JeremyL71/GMP-Projet-fusex/CAO/Bluemoon 1bis (last)2/bride de maintien.SLDPRT

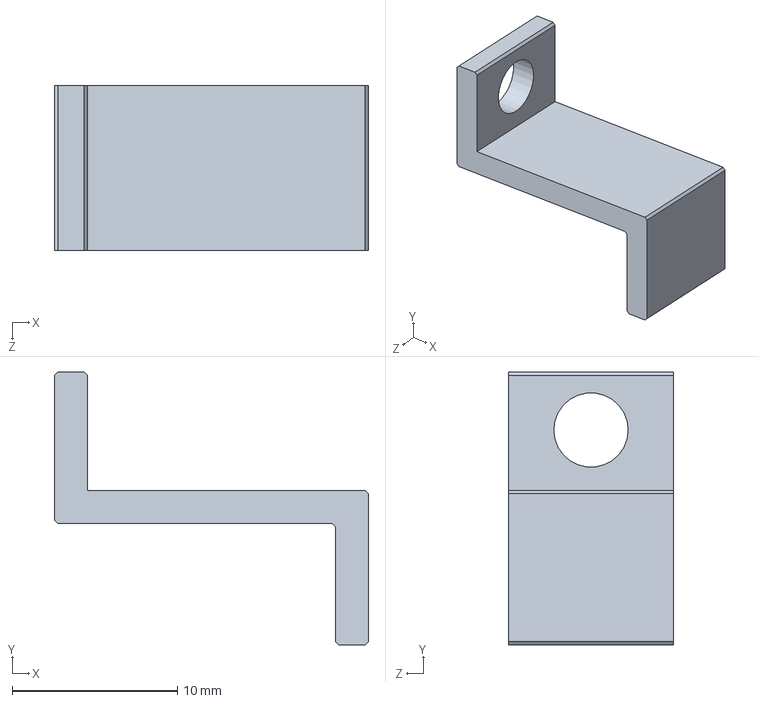
[picture p10: CAD file, 2020-04-03]
CAO/Bluemoon 1bis (last)2/bride de maintien.SLDPRT
19.0 x 16.5 x 10.0 mm
