JeremyL71/GMP-Projet-fusex/CAO/Bluemoon 1bis (last)2/SA aileronss.SLDASM

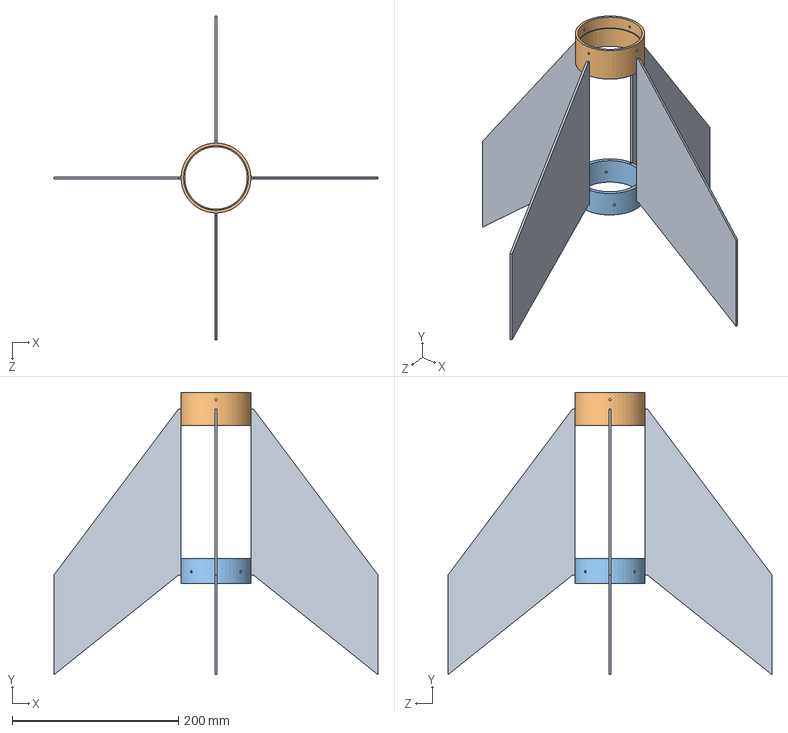
[picture p11: CAD file, 2020-04-03]
CAO/Bluemoon 1bis (last)2/SA aileronss.SLDASM
390.0 x 340.0 x 390.0 mm
Aileron x 4
Bague Ailerons
Bague Ailerons 2
