JeremyL71/GMP-Projet-fusex/CAO/support/Support.SLDASM

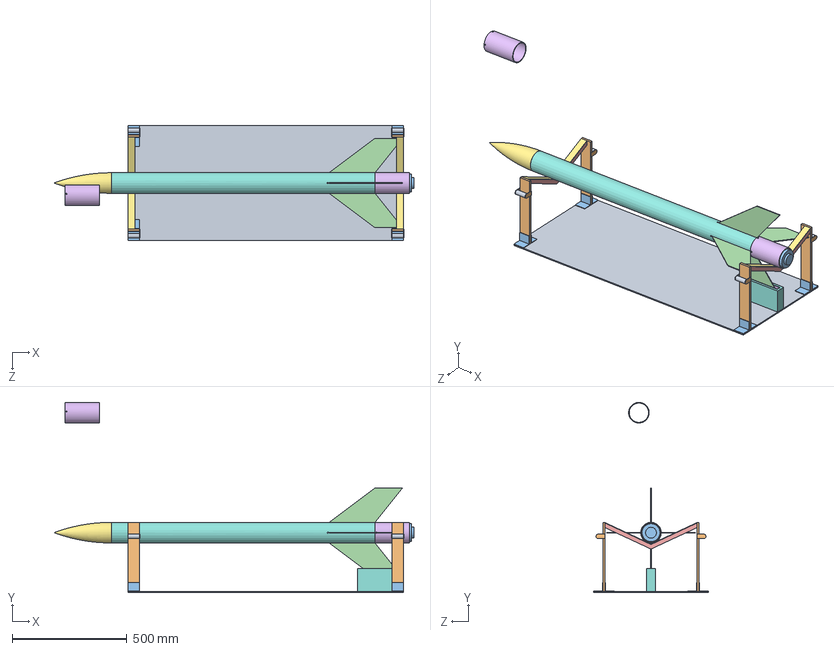
[picture p12: CAD file, 2020-04-03]
CAO/support/Support.SLDASM
1570.0 x 829.5 x 500.0 mm
Plaque
Barre verticel x 4
maintient x 8
Aileron x 4
Bague Ailerons x 2
ogive 1bis
Tube supérieur
Tube Bas
Cloison x 2
tube capteurs 1bis
Moteur 1bis
Bague supérieur moteur
Pièce1 x 2
revetPièce2
dessusPièce1 x 2
Pièce2 x 2
Pièce3 x 4
Pièce4 x 8
