JeremyL71/GMP-Projet-fusex/CAO/Bluemoon 1bis (last)2/Sol 1 Porte Capteurs.SLDASM

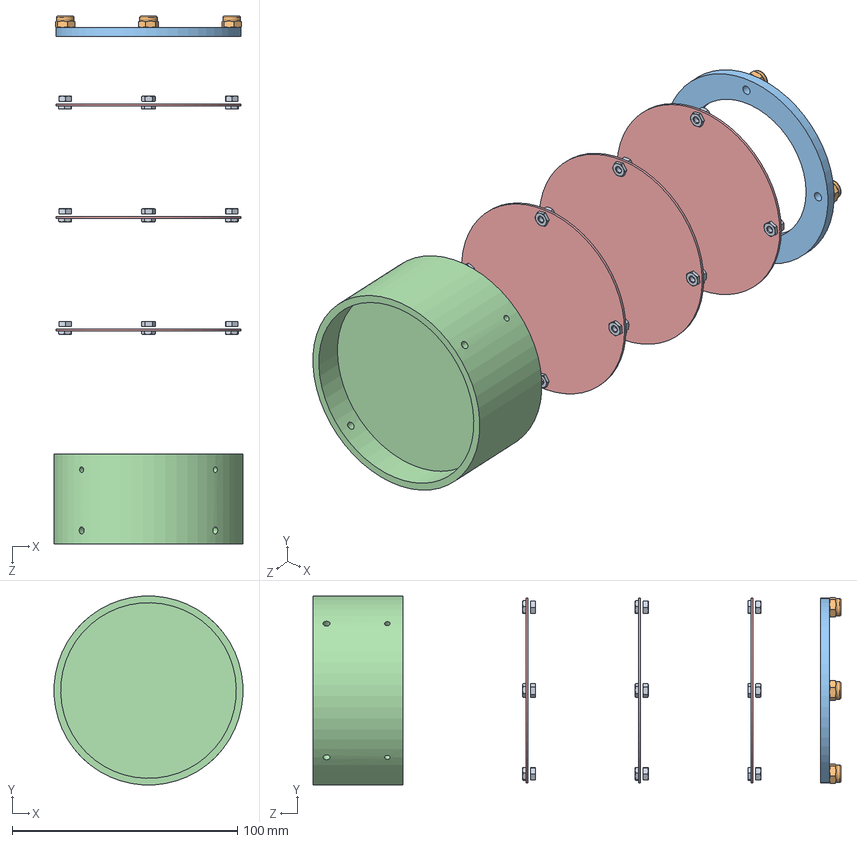
[picture p13: CAD file, 2020-04-03]
CAO/Bluemoon 1bis (last)2/Sol 1 Porte Capteurs.SLDASM
83.8 x 83.8 x 234.5 mm
Cloison
+®crou autofrein+® x 4
Cloison 2
Porte capteur x 3
+®crou m3 x 24
