JeremyL71/GMP-Projet-fusex/CAO/support/SA AILERONS.SLDASM

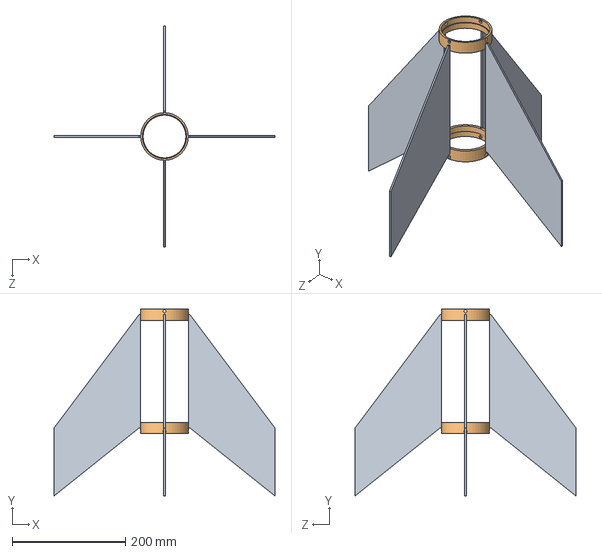
[picture p14: CAD file, 2020-04-03]
CAO/support/SA AILERONS.SLDASM
390.0 x 330.0 x 390.0 mm
Aileron x 4
Bague Ailerons x 2
