JeremyL71/GMP-Projet-fusex/CAO/support/1. SA CORP.SLDASM

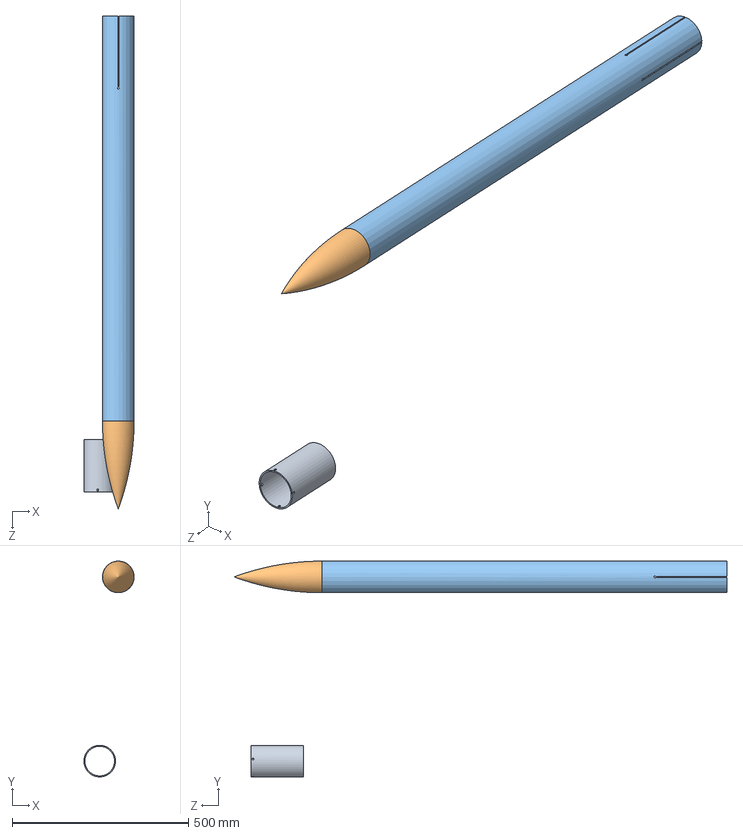
[picture p15: CAD file, 2020-04-03]
CAO/support/1. SA CORP.SLDASM
142.8 x 613.1 x 1400.0 mm
Tube Bas
ogive 1bis
Tube supérieur
