JeremyL71/GMP-Projet-fusex/CAO/Bluemoon 1bis (last)2/FUSEE 1BIS 2.SLDASM

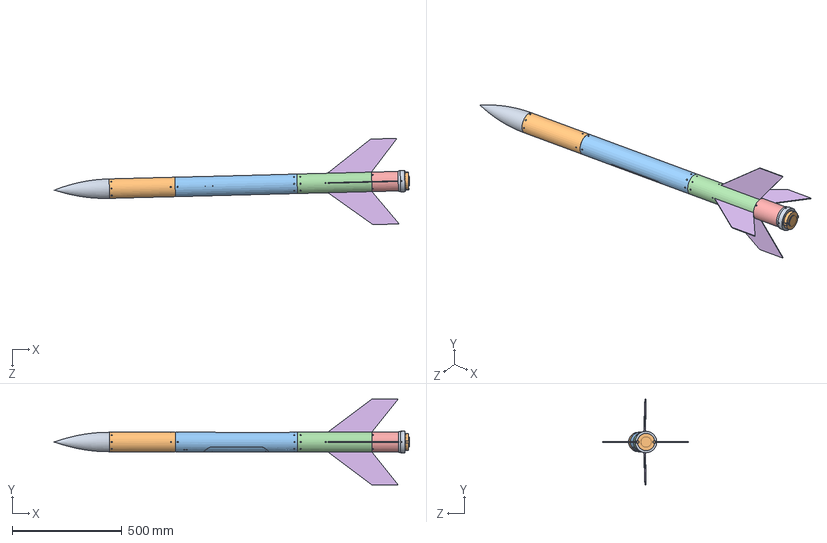
[picture p16: CAD file, 2020-04-03]
CAO/Bluemoon 1bis (last)2/FUSEE 1BIS 2.SLDASM
1617.3 x 390.0 x 393.0 mm
ogive 2
tube haut
Tube 2
Tube 3a
Tube 4
Aileron x 4
Bague Ailerons
Bague Ailerons 2
Cloison pleine
Propulseur
Cloison
tige filet+® x 4
+®crou autofrein+® x 4
Cloison 2
Porte capteur x 3
+®crou m3 x 24
Bague maintient bas
bride de maintien x 2
Trappe
Servo 360
Disque servo
Guidage goupille
Bride servo x 2
Rivets d3x10x120 x 50
Maintien goupille
Guidage ressort
