JeremyL71/GMP-Projet-fusex/CAO/support/fusée 1bis 2.SLDASM

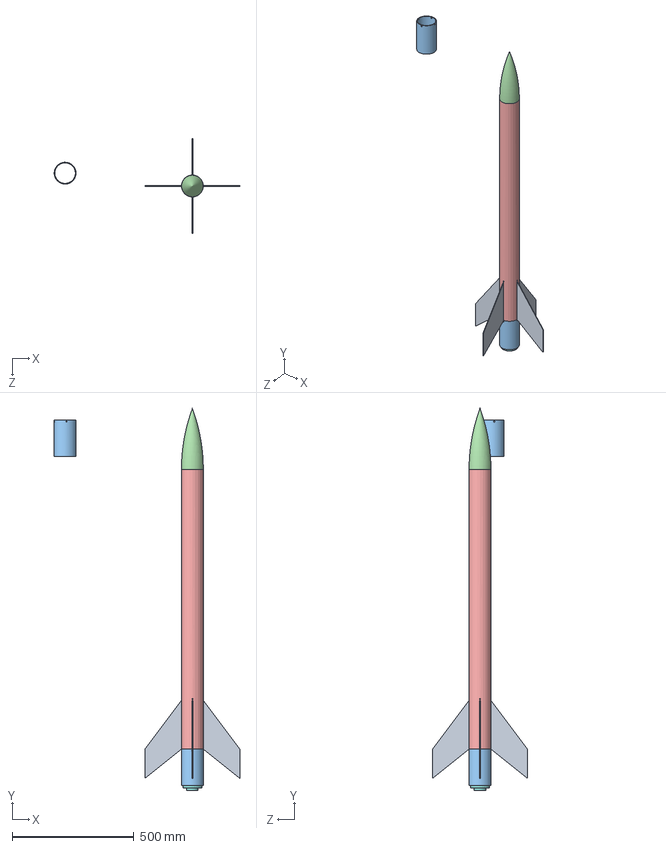
[picture p17: CAD file, 2020-04-03]
CAO/support/fusée 1bis 2.SLDASM
763.1 x 1570.0 x 390.0 mm
Aileron x 4
Bague Ailerons x 2
ogive 1bis
Tube supérieur
Tube Bas
Cloison x 2
tube capteurs 1bis
Moteur 1bis
Bague supérieur moteur
