JeremyL71/GMP-Projet-fusex/CAO/support/maintient.SLDPRT

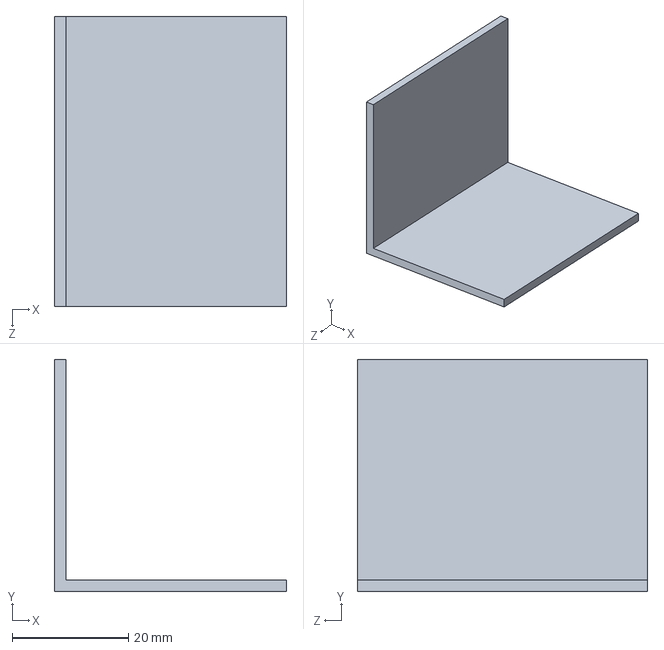
[picture p18: CAD file, 2020-04-03]
CAO/support/maintient.SLDPRT
40.0 x 40.0 x 50.0 mm
