JeremyL71/GMP-Projet-fusex/CAO/Bluemoon 1bis (last)2/Maintien goupille.SLDPRT

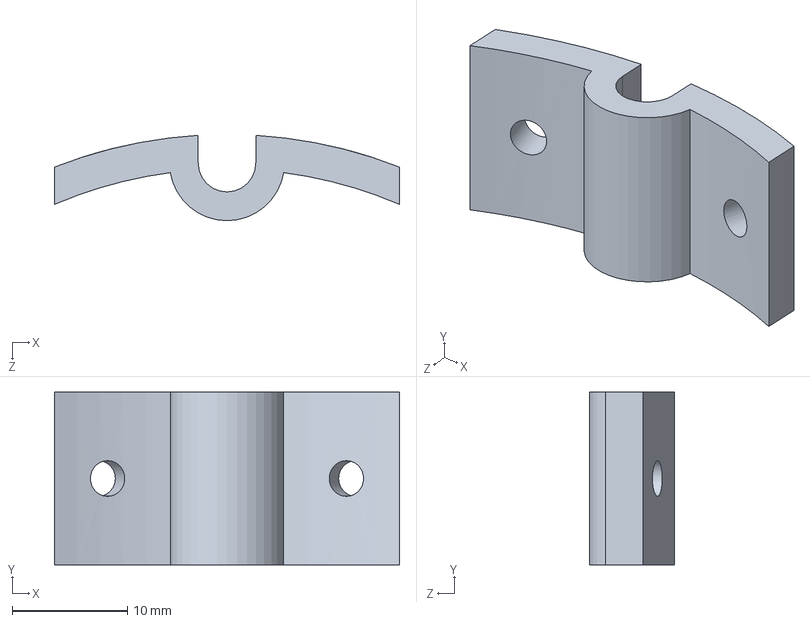
[picture p19: CAD file, 2020-04-03]
CAO/Bluemoon 1bis (last)2/Maintien goupille.SLDPRT
30.0 x 15.0 x 7.42 mm
