JeremyL71/GMP-Projet-fusex/CAO/support/poigné.SLDASM

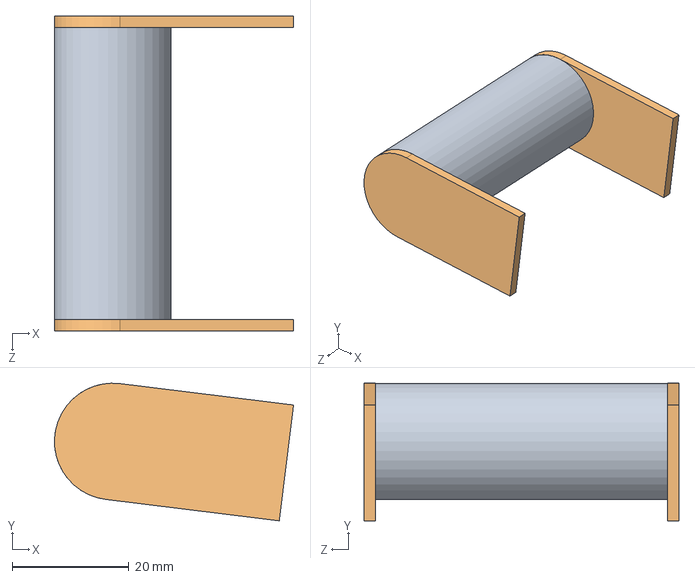
[picture p20: CAD file, 2020-04-03]
CAO/support/poigné.SLDASM
41.0 x 23.6 x 54.0 mm
Pièce3
Pièce4 x 2
