JeremyL71/GMP-Projet-fusex/CAO/Bluemoon 1bis (last)2/Bague maintient bas.SLDPRT

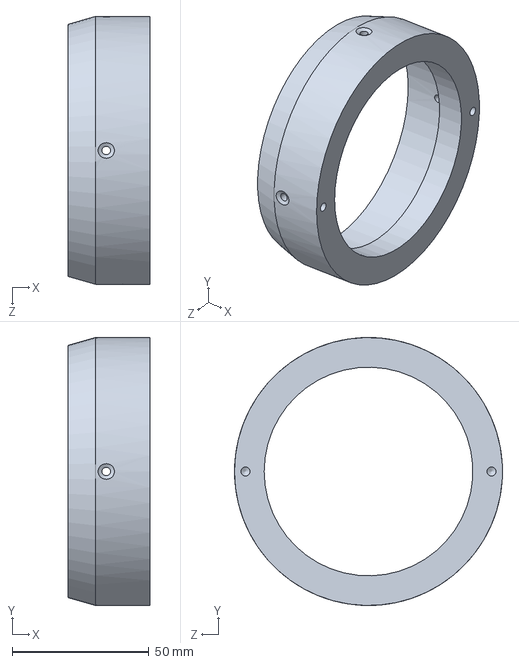
[picture p21: CAD file, 2020-04-03]
CAO/Bluemoon 1bis (last)2/Bague maintient bas.SLDPRT
30.0 x 98.0 x 98.0 mm
