JeremyL71/GMP-Projet-fusex/CAO/Bluemoon 1bis (last)2/Servo 360-¦.SLDASM

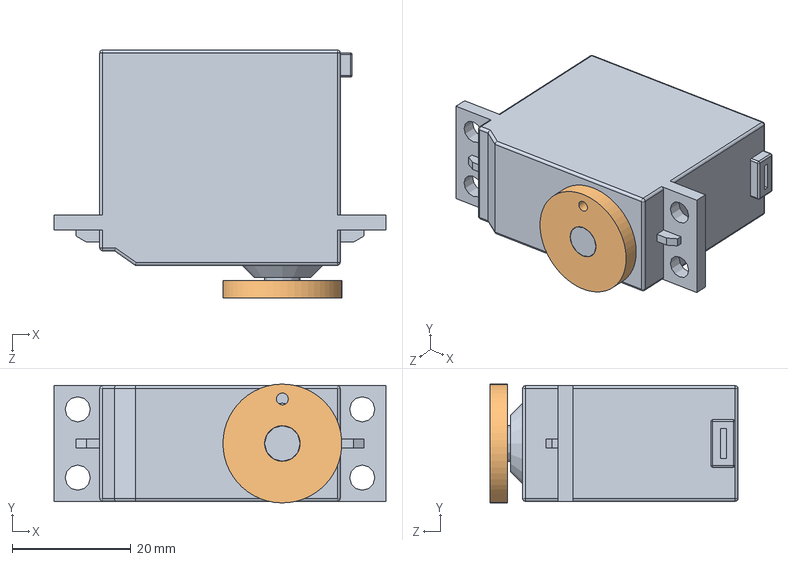
[picture p22: CAD file, 2020-04-03]
CAO/Bluemoon 1bis (last)2/Servo 360-¦.SLDASM
55.9 x 20.0 x 41.8 mm
Servo 360
Disque servo
