JeremyL71/GMP-Projet-fusex/CAO/Bluemoon 1bis (last)2/Disque servo.SLDPRT

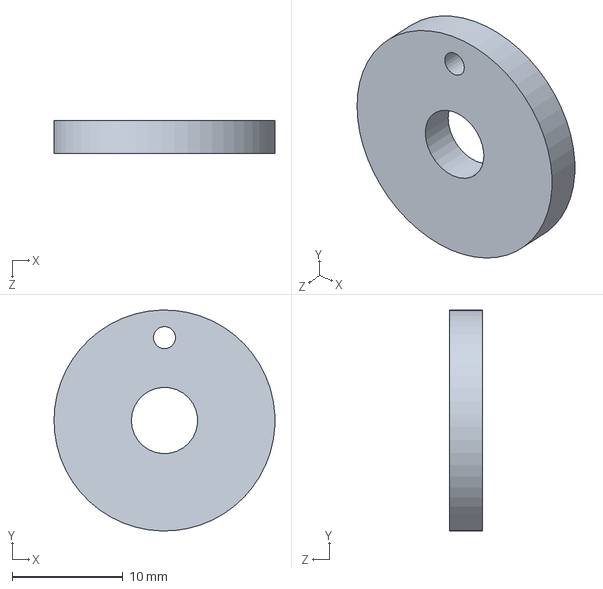
[picture p23: CAD file, 2020-04-03]
CAO/Bluemoon 1bis (last)2/Disque servo.SLDPRT
20.0 x 20.0 x 3.00 mm
