JeremyL71/GMP-Projet-fusex/CAO/Ogive/ogive 2 .STEP

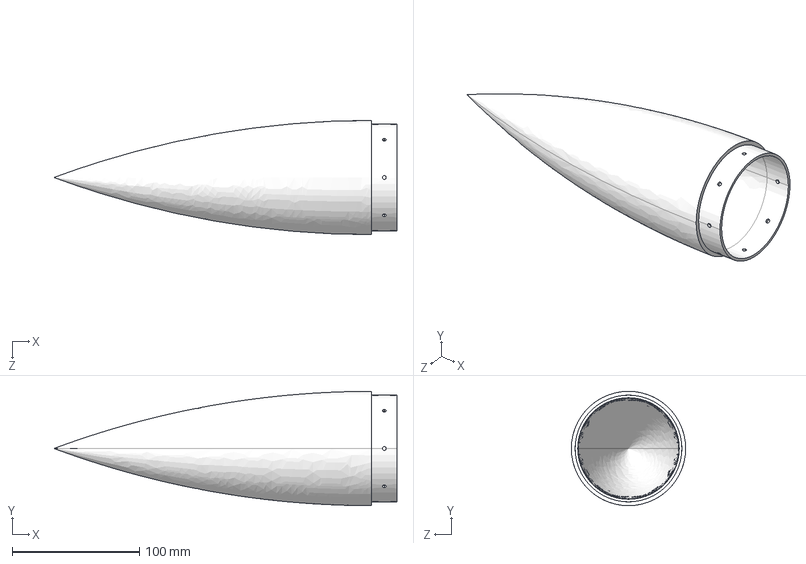
[picture p24: CAD file, 2020-04-03]
CAO/Ogive/ogive 2 .STEP
270.0 x 90.0 x 90.0 mm
