JeremyL71/GMP-Projet-fusex/CAO/support/Pièce1.SLDPRT

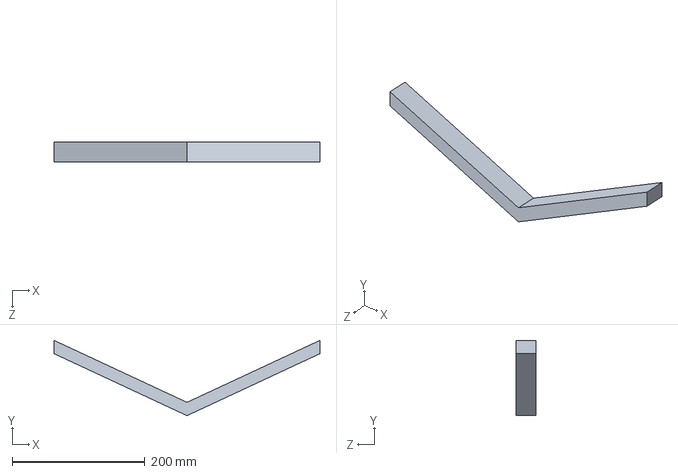
[picture p25: CAD file, 2020-04-03]
CAO/support/Pièce1.SLDPRT
400.0 x 113.3 x 30.0 mm
