JeremyL71/GMP-Projet-fusex/CAO/Bluemoon 1bis (last)2/rondelle +®ventail.SLDPRT

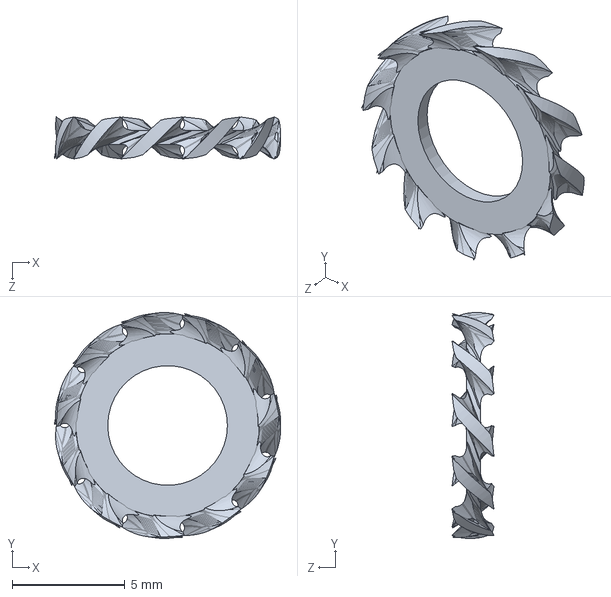
[picture p26: CAD file, 2020-04-03]
CAO/Bluemoon 1bis (last)2/rondelle +®ventail.SLDPRT
10.0 x 10.0 x 1.86 mm
