JeremyL71/GMP-Projet-fusex/CAO/support/Pièce5.SLDPRT

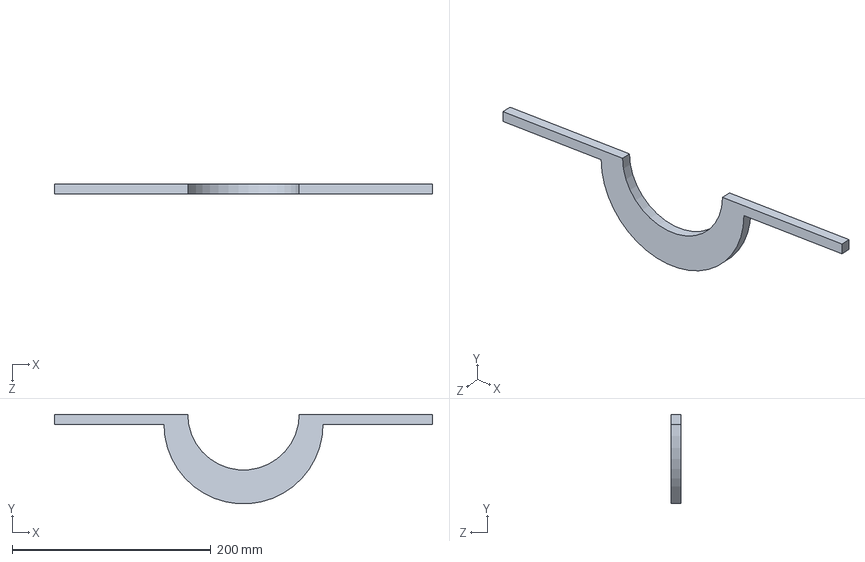
[picture p27: CAD file, 2020-04-03]
CAO/support/Pièce5.SLDPRT
380.0 x 89.8 x 10.0 mm
