JeremyL71/GMP-Projet-fusex/CAO/Bluemoon 1bis (last)2/Propulseur.SLDPRT

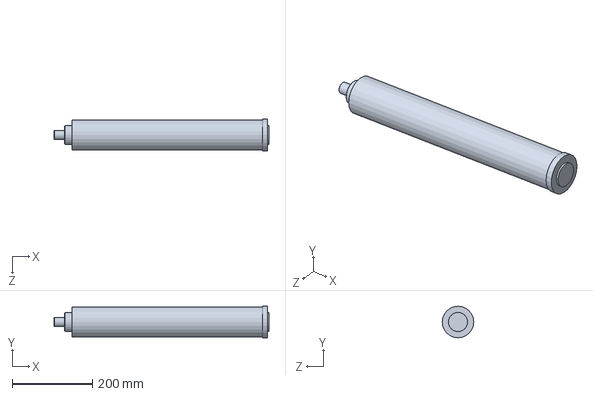
[picture p28: CAD file, 2020-04-03]
CAO/Bluemoon 1bis (last)2/Propulseur.SLDPRT
536.0 x 78.7 x 78.7 mm
