JeremyL71/GMP-Projet-fusex/CAO/Ogive/ogive 3 moule.SLDPRT

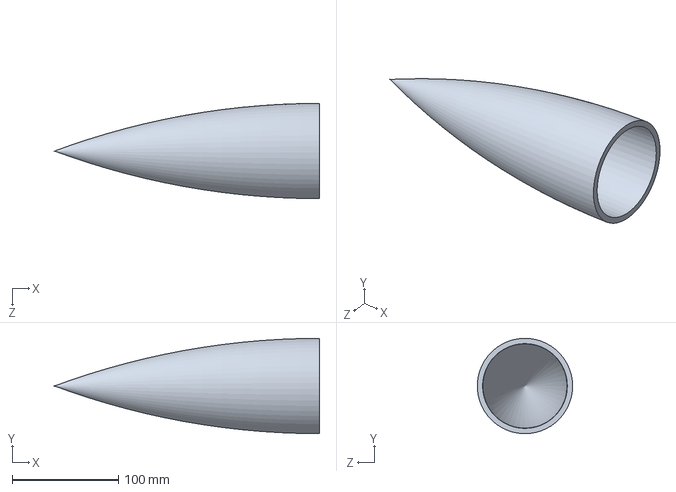
[picture p29: CAD file, 2020-04-03]
CAO/Ogive/ogive 3 moule.SLDPRT
250.0 x 90.0 x 89.9 mm
