JeremyL71/GMP-Projet-fusex/CAO/support/Tube supérieur.SLDPRT

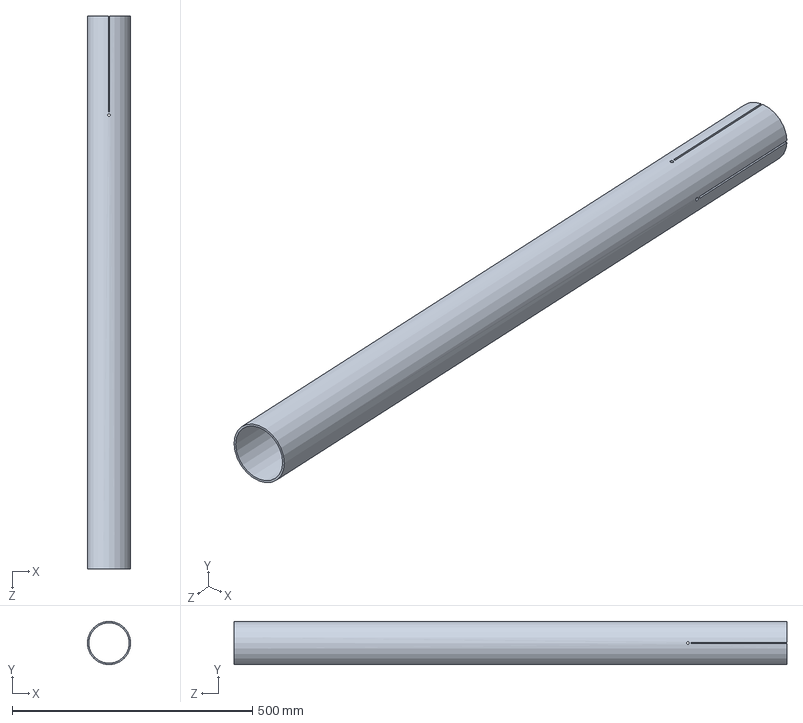
[picture p30: CAD file, 2020-04-03]
CAO/support/Tube supérieur.SLDPRT
90.0 x 90.0 x 1150.0 mm
