JeremyL71/GMP-Projet-fusex/CAO/Bluemoon 1bis (last)2/Aileron.SLDPRT

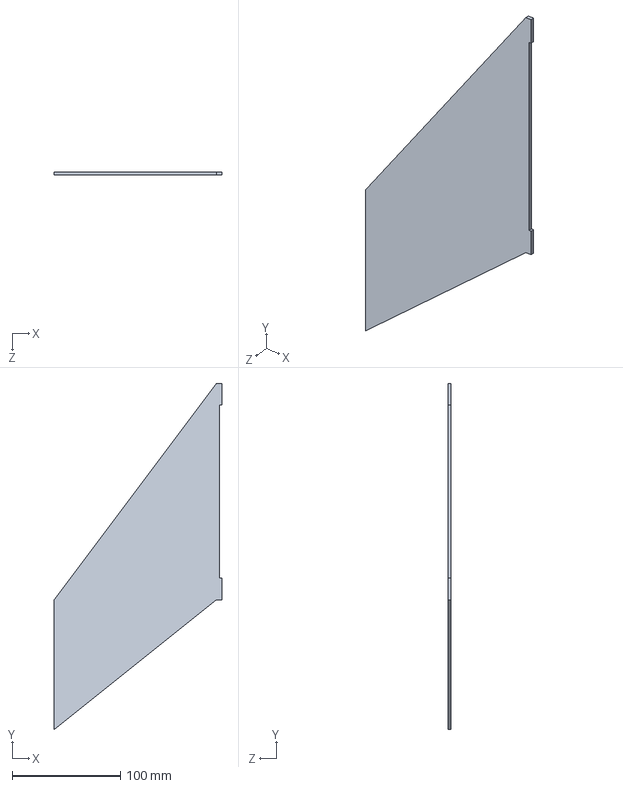
[picture p31: CAD file, 2020-04-03]
CAO/Bluemoon 1bis (last)2/Aileron.SLDPRT
155.0 x 320.0 x 3.00 mm
