JeremyL71/GMP-Projet-fusex/CAO/support/ogive 1bis.SLDPRT

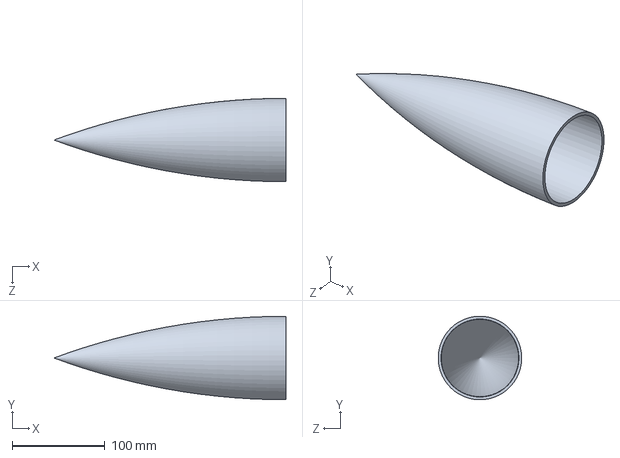
[picture p32: CAD file, 2020-04-03]
CAO/support/ogive 1bis.SLDPRT
250.0 x 90.0 x 89.9 mm
