JeremyL71/GMP-Projet-fusex/CAO/support/Bague supérieur moteur.SLDPRT

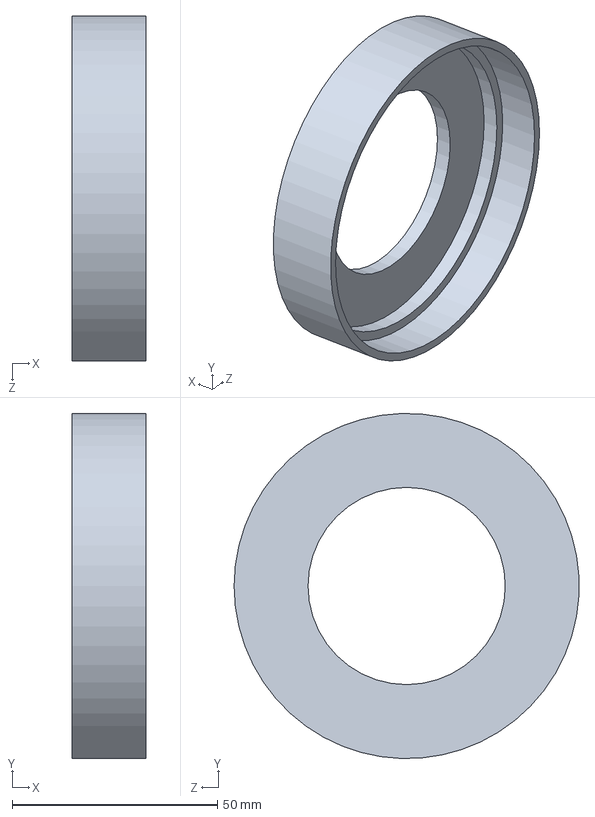
[picture p33: CAD file, 2020-04-03]
CAO/support/Bague supérieur moteur.SLDPRT
18.0 x 84.0 x 83.9 mm
