JeremyL71/GMP-Projet-fusex/CAO/Bluemoon 1bis (last)2/Cloison pleine.SLDPRT

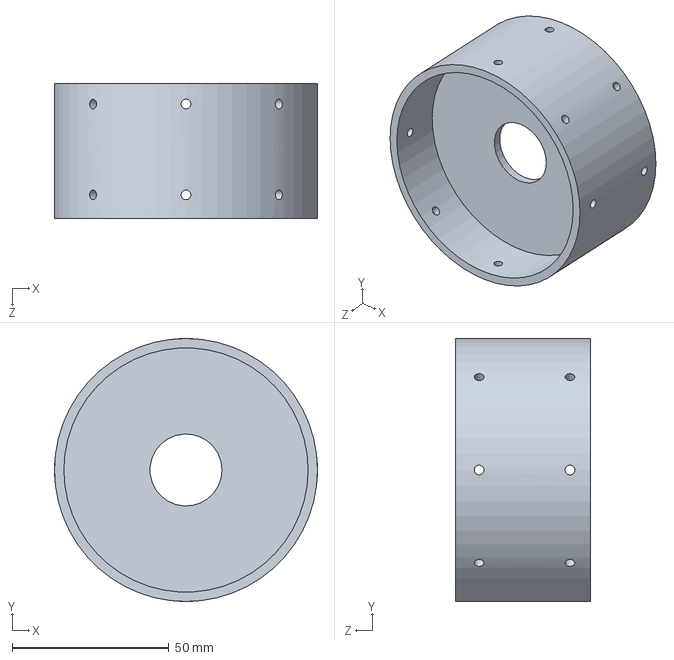
[picture p34: CAD file, 2020-04-03]
CAO/Bluemoon 1bis (last)2/Cloison pleine.SLDPRT
84.0 x 84.0 x 43.0 mm
