JeremyL71/GMP-Projet-fusex/CAO/support/Pièce2.SLDPRT

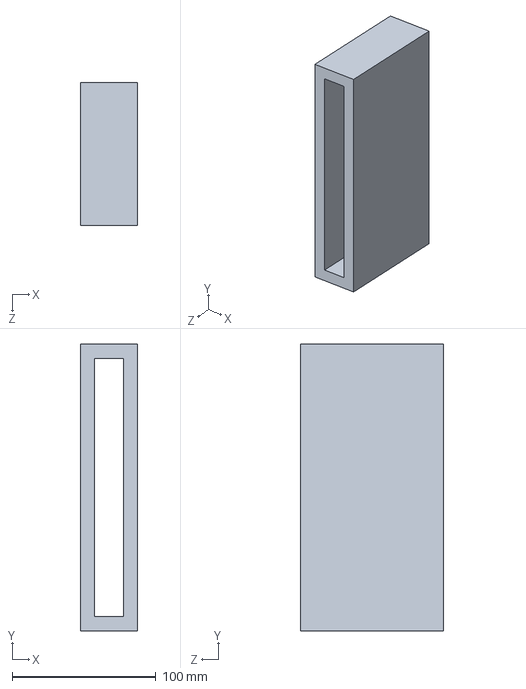
[picture p35: CAD file, 2020-04-03]
CAO/support/Pièce2.SLDPRT
40.0 x 200.0 x 100.0 mm
