JeremyL71/GMP-Projet-fusex/CAO/support/tube capteurs 1bis.SLDPRT

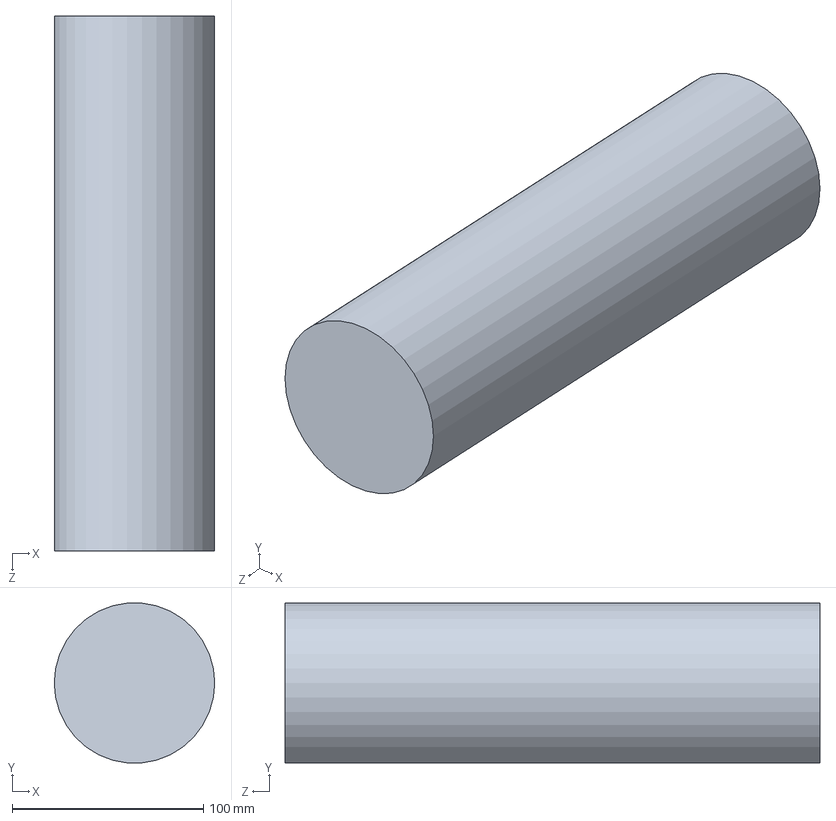
[picture p36: CAD file, 2020-04-03]
CAO/support/tube capteurs 1bis.SLDPRT
84.0 x 83.6 x 280.0 mm
