JeremyL71/GMP-Projet-fusex/CAO/Bluemoon 1bis (last)2/Tube 2.SLDPRT

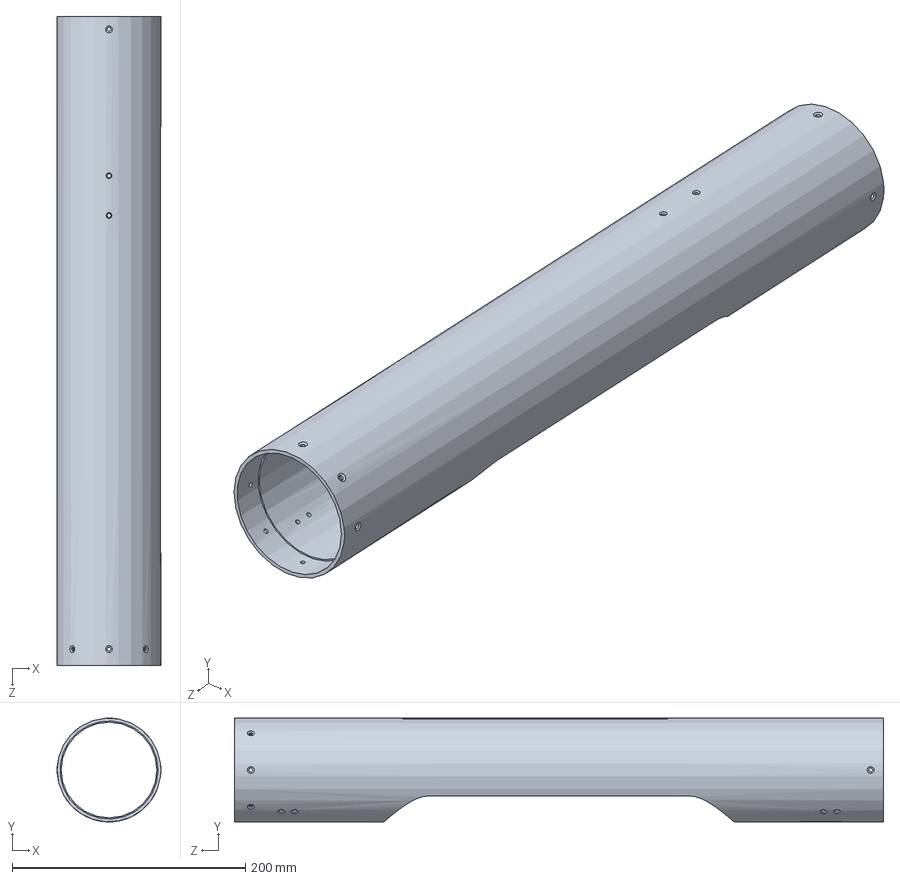
[picture p37: CAD file, 2020-04-03]
CAO/Bluemoon 1bis (last)2/Tube 2.SLDPRT
89.0 x 89.0 x 556.0 mm
