JeremyL71/GMP-Projet-fusex/CAO/support/Pièce3.SLDPRT

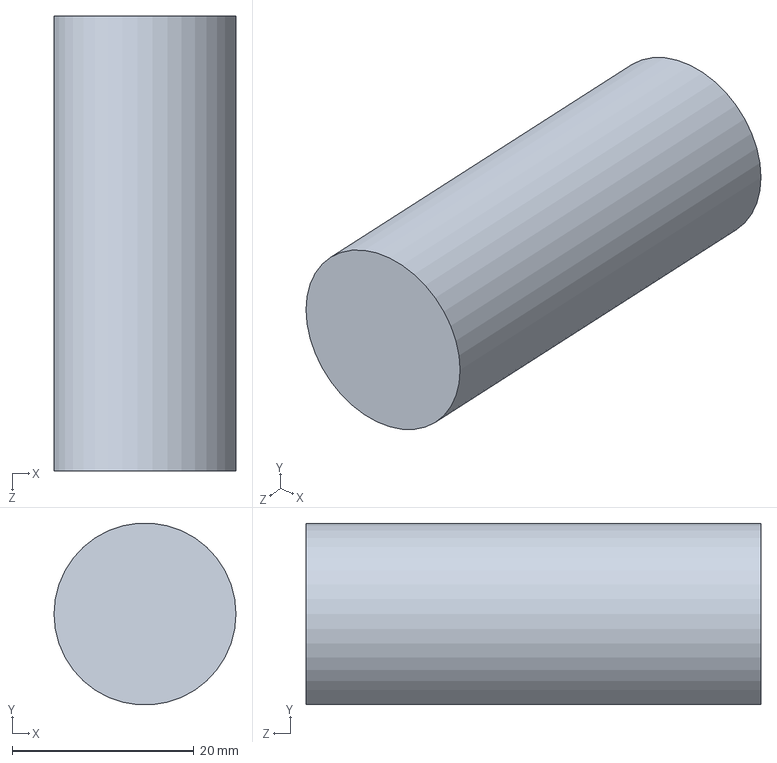
[picture p38: CAD file, 2020-04-03]
CAO/support/Pièce3.SLDPRT
20.0 x 19.9 x 50.0 mm
