JeremyL71/GMP-Projet-fusex/CAO/Bluemoon 1bis (last)2/Guidage goupille.SLDPRT

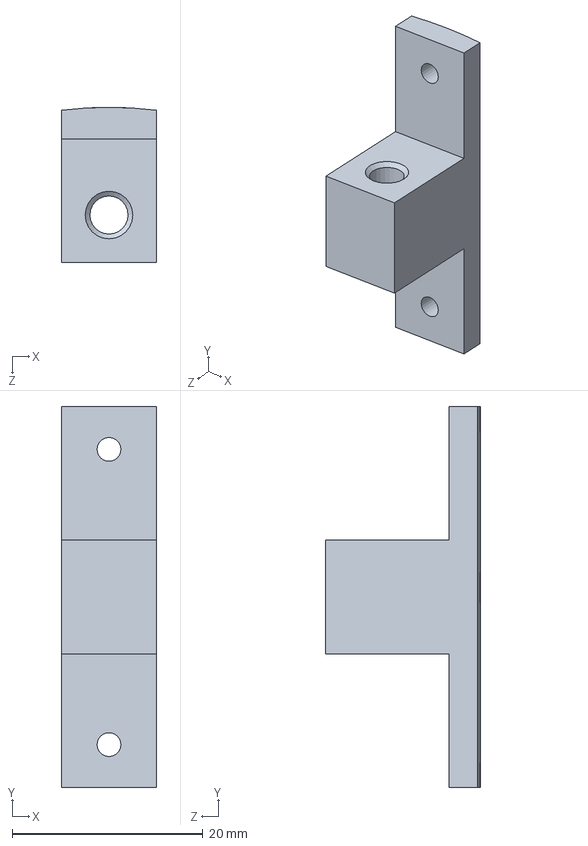
[picture p39: CAD file, 2020-04-03]
CAO/Bluemoon 1bis (last)2/Guidage goupille.SLDPRT
10.0 x 40.0 x 16.3 mm
