JeremyL71/GMP-Projet-fusex/CAO/support/dessusPièce1.SLDPRT

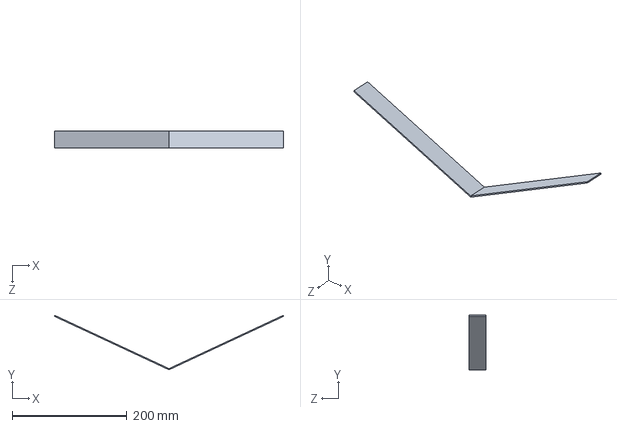
[picture p40: CAD file, 2020-04-03]
CAO/support/dessusPièce1.SLDPRT
400.0 x 95.3 x 30.0 mm
