JeremyL71/GMP-Projet-fusex/CAO/Bluemoon 1bis (last)2/Guidage ressort.SLDPRT

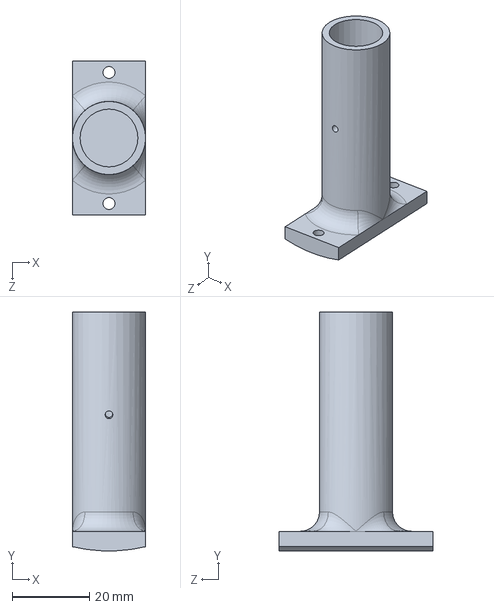
[picture p41: CAD file, 2020-04-03]
CAO/Bluemoon 1bis (last)2/Guidage ressort.SLDPRT
19.0 x 62.0 x 40.0 mm
