JeremyL71/GMP-Projet-fusex/CAO/support/Barre TRansverse.SLDPRT

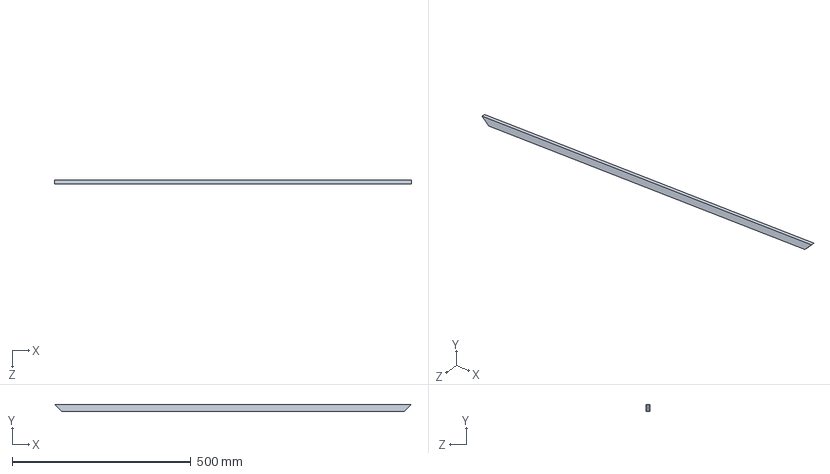
[picture p42: CAD file, 2020-04-03]
CAO/support/Barre TRansverse.SLDPRT
1000.0 x 20.0 x 10.0 mm
