JeremyL71/GMP-Projet-fusex/CAO/Bluemoon 1bis (last)2/Trappe.SLDPRT

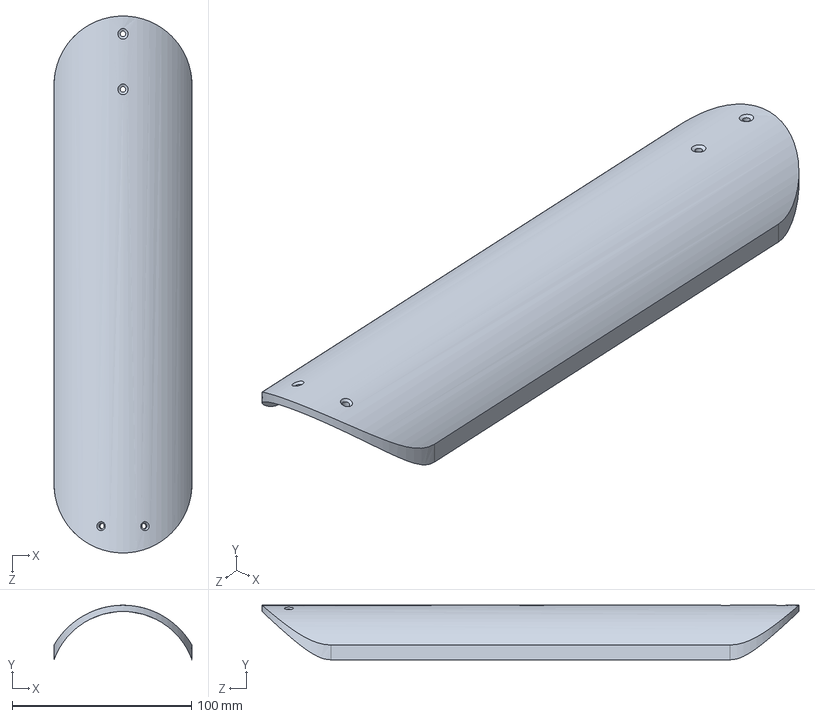
[picture p43: CAD file, 2020-04-03]
CAO/Bluemoon 1bis (last)2/Trappe.SLDPRT
77.1 x 30.5 x 300.0 mm
