JeremyL71/GMP-Projet-fusex/CAO/support/Bague Ailerons.SLDPRT

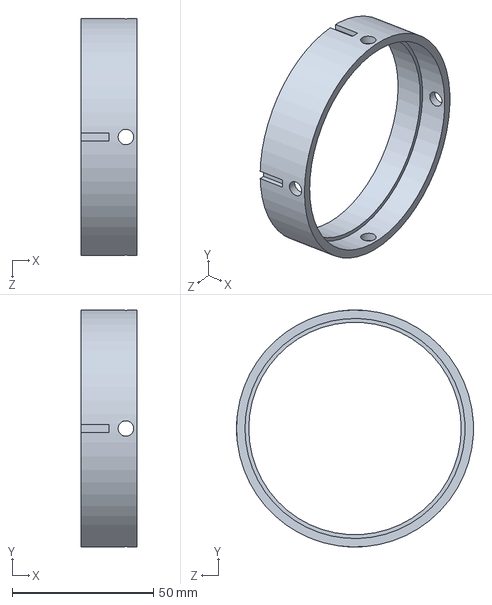
[picture p44: CAD file, 2020-04-03]
CAO/support/Bague Ailerons.SLDPRT
20.0 x 84.0 x 84.0 mm
