JeremyL71/GMP-Projet-fusex/CAO/Bluemoon 1bis (last)2/+®crou autofrein+®.SLDPRT

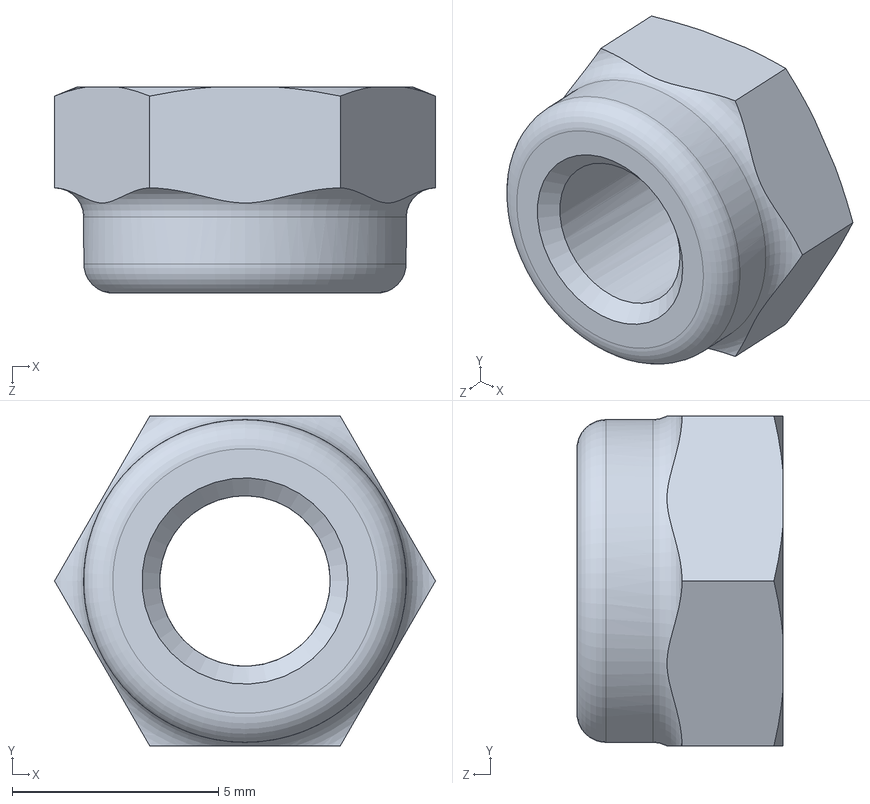
[picture p45: CAD file, 2020-04-03]
CAO/Bluemoon 1bis (last)2/+®crou autofrein+®.SLDPRT
9.24 x 8.00 x 5.00 mm
