JeremyL71/GMP-Projet-fusex/CAO/support/Bague inférieure moteur.SLDPRT

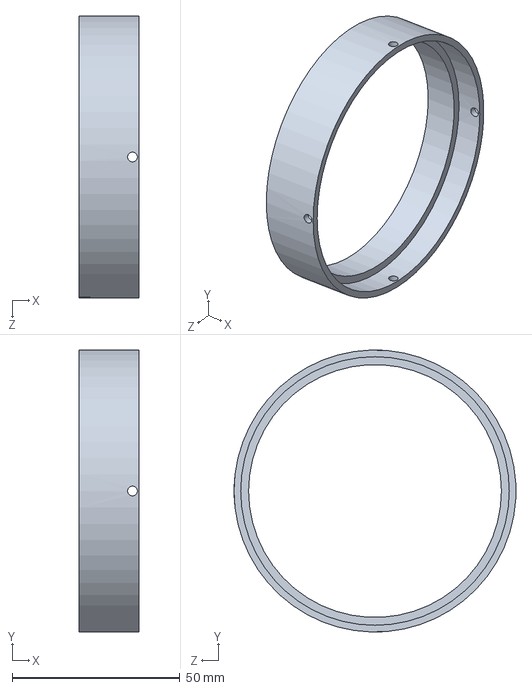
[picture p46: CAD file, 2020-04-03]
CAO/support/Bague inférieure moteur.SLDPRT
18.0 x 84.0 x 84.0 mm
