JeremyL71/GMP-Projet-fusex/CAO/Bluemoon 1bis (last)2/+®crou m3.SLDPRT

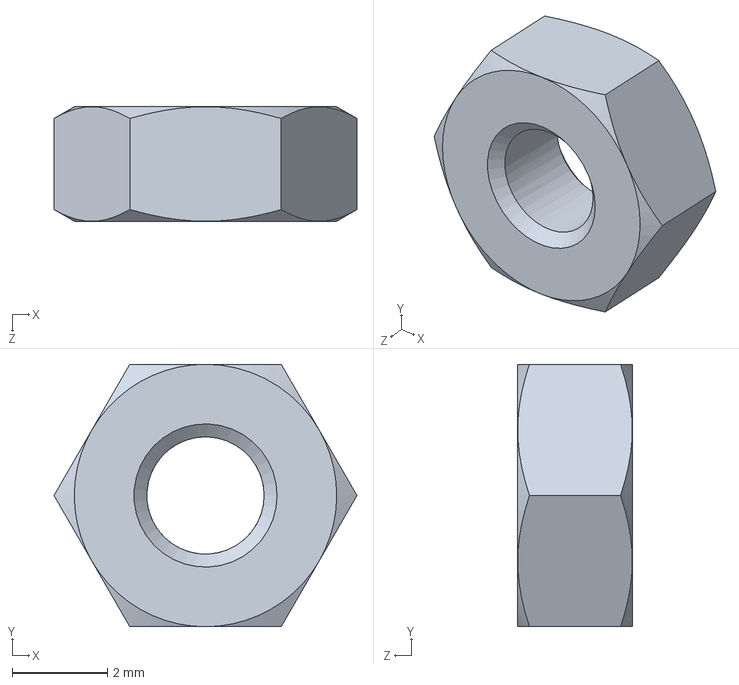
[picture p47: CAD file, 2020-04-03]
CAO/Bluemoon 1bis (last)2/+®crou m3.SLDPRT
6.35 x 5.50 x 2.40 mm
