JeremyL71/GMP-Projet-fusex/CAO/support/Barre verticel.SLDPRT

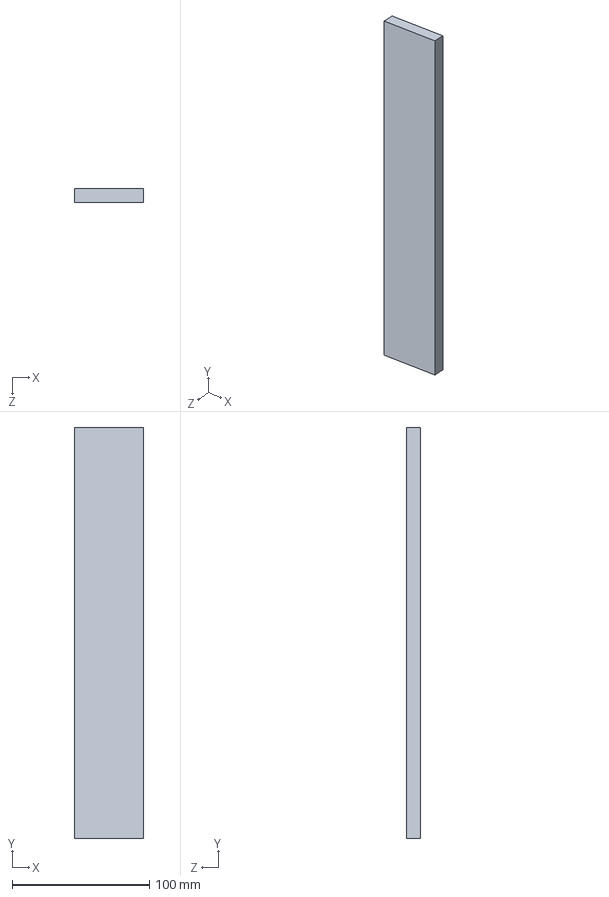
[picture p48: CAD file, 2020-04-03]
CAO/support/Barre verticel.SLDPRT
50.0 x 300.0 x 10.0 mm
