JeremyL71/GMP-Projet-fusex/CAO/Bluemoon 1bis (last)2/ogive 2 .SLDPRT

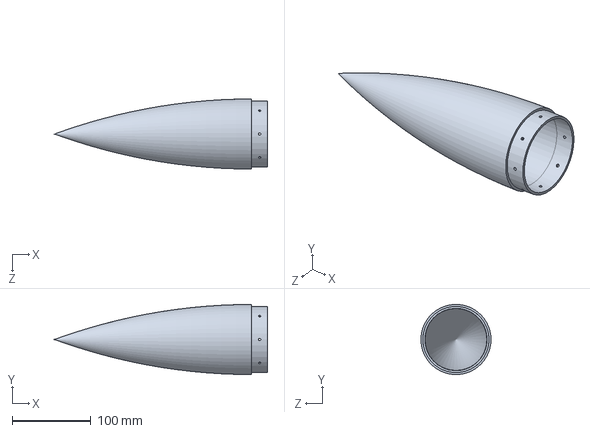
[picture p49: CAD file, 2020-04-03]
CAO/Bluemoon 1bis (last)2/ogive 2 .SLDPRT
270.0 x 89.0 x 88.9 mm
