JeremyL71/GMP-Projet-fusex/CAO/support/Tube Bas.SLDPRT

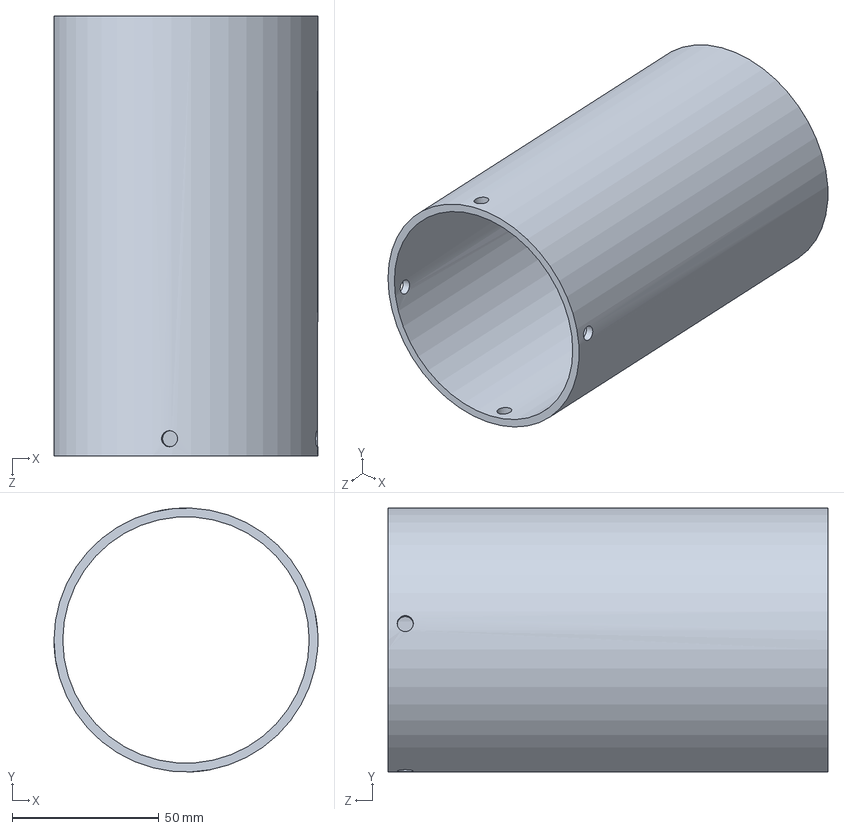
[picture p50: CAD file, 2020-04-03]
CAO/support/Tube Bas.SLDPRT
90.0 x 89.9 x 150.0 mm
