JeremyL71/GMP-Projet-fusex/CAO/Bluemoon 1bis (last)2/Bague Ailerons 2.SLDPRT

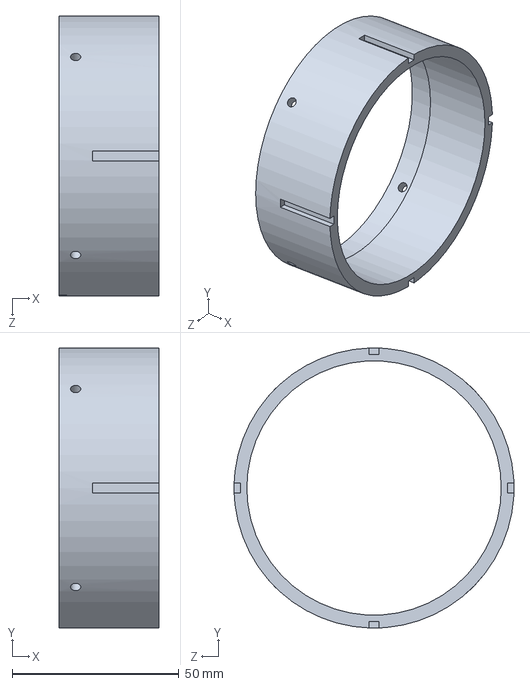
[picture p51: CAD file, 2020-04-03]
CAO/Bluemoon 1bis (last)2/Bague Ailerons 2.SLDPRT
30.0 x 84.0 x 84.0 mm
