JeremyL71/GMP-Projet-fusex/CAO/support/revetPièce2.SLDPRT

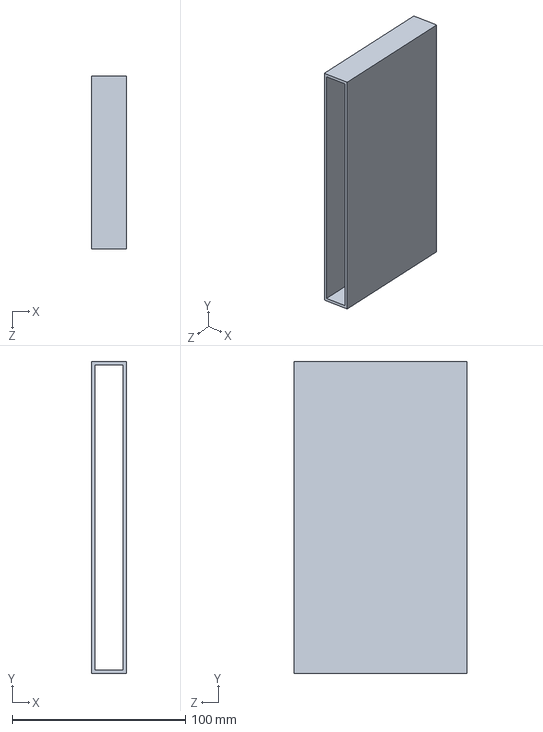
[picture p52: CAD file, 2020-04-03]
CAO/support/revetPièce2.SLDPRT
20.0 x 180.0 x 100.0 mm
