JeremyL71/GMP-Projet-fusex/CAO/Bluemoon 1bis (last)2/Cloison 2.SLDPRT

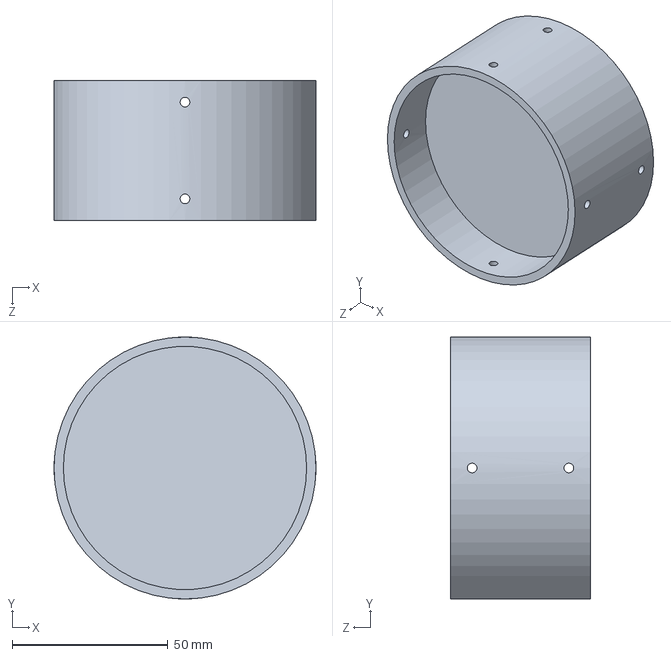
[picture p53: CAD file, 2020-04-03]
CAO/Bluemoon 1bis (last)2/Cloison 2.SLDPRT
84.0 x 84.0 x 45.0 mm
