JeremyL71/GMP-Projet-fusex/CAO/Bluemoon 1bis (last)2/Tube 3a.SLDPRT

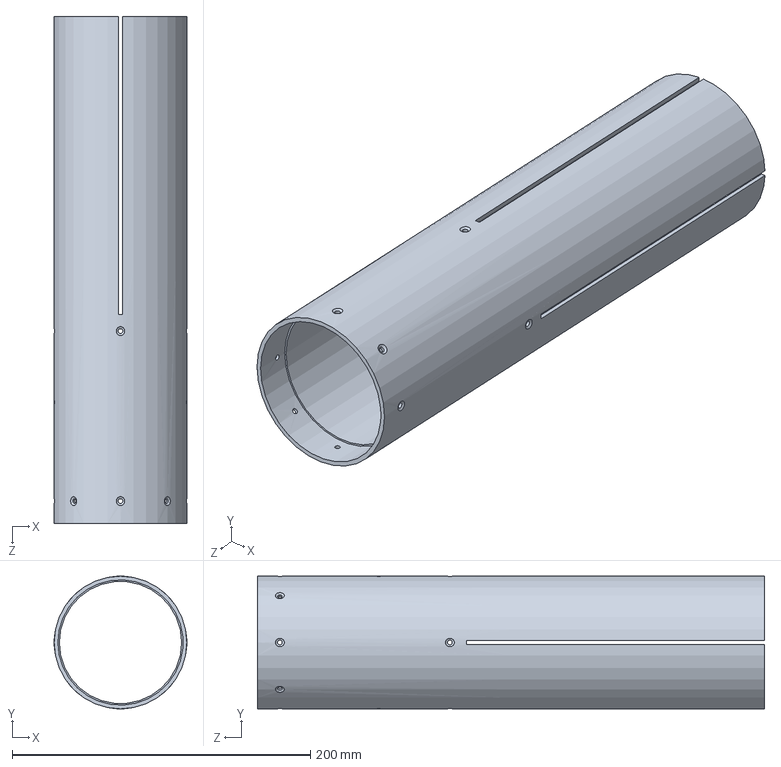
[picture p54: CAD file, 2020-04-03]
CAO/Bluemoon 1bis (last)2/Tube 3a.SLDPRT
89.0 x 89.0 x 340.0 mm
