JeremyL71/GMP-Projet-fusex/CAO/Bluemoon 1bis (last)2/Rivets d3x10x120.SLDPRT

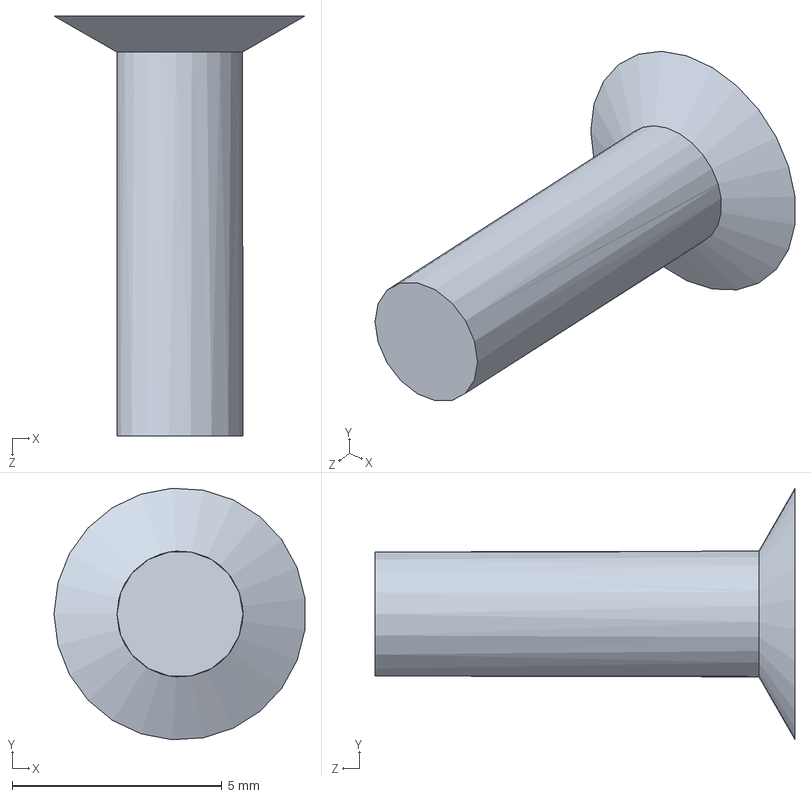
[picture p55: CAD file, 2020-04-03]
CAO/Bluemoon 1bis (last)2/Rivets d3x10x120.SLDPRT
5.98 x 5.99 x 10.0 mm
