JeremyL71/GMP-Projet-fusex/CAO/support/Pièce4.SLDPRT

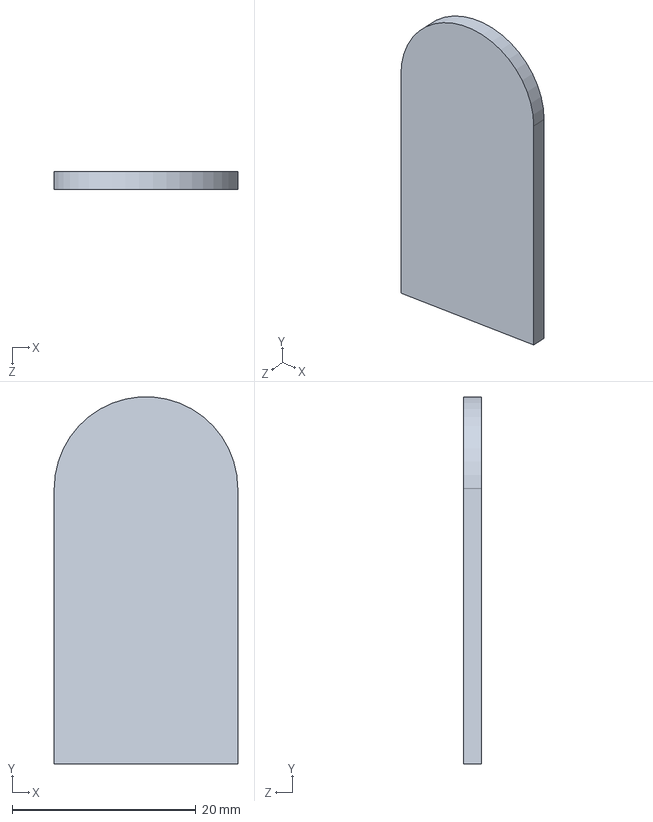
[picture p56: CAD file, 2020-04-03]
CAO/support/Pièce4.SLDPRT
20.0 x 40.0 x 2.00 mm
