JeremyL71/GMP-Projet-fusex/CAO/Bluemoon 1bis (last)2/Cloison.SLDPRT

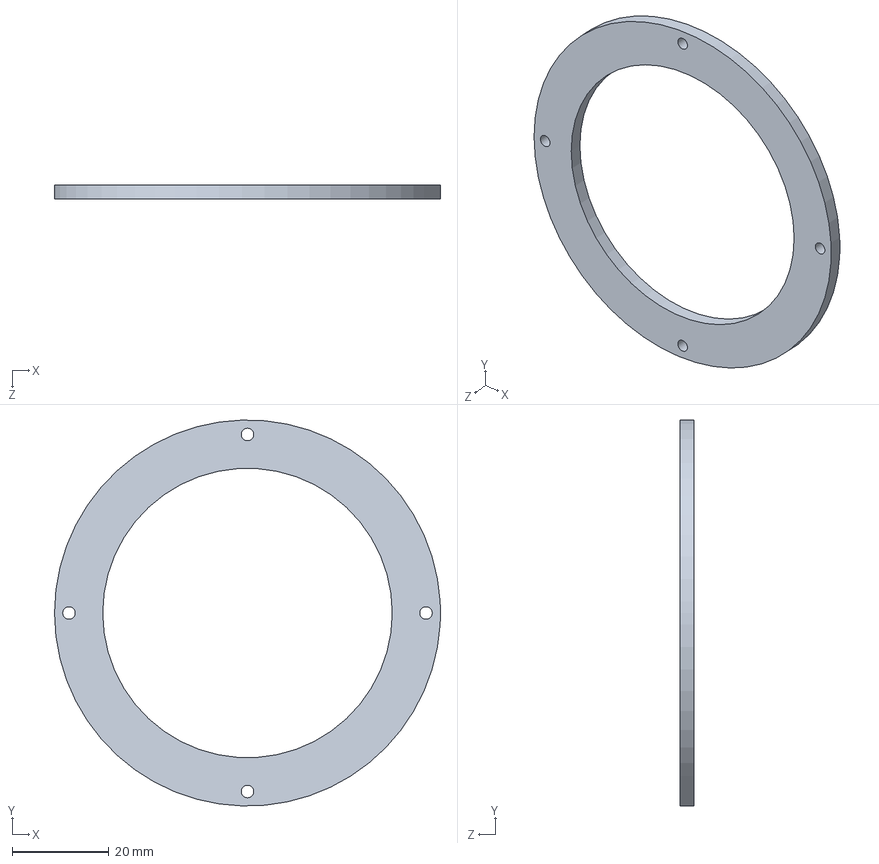
[picture p57: CAD file, 2020-04-03]
CAO/Bluemoon 1bis (last)2/Cloison.SLDPRT
80.0 x 80.0 x 3.00 mm
