JeremyL71/GMP-Projet-fusex/CAO/support/Plaque.SLDPRT

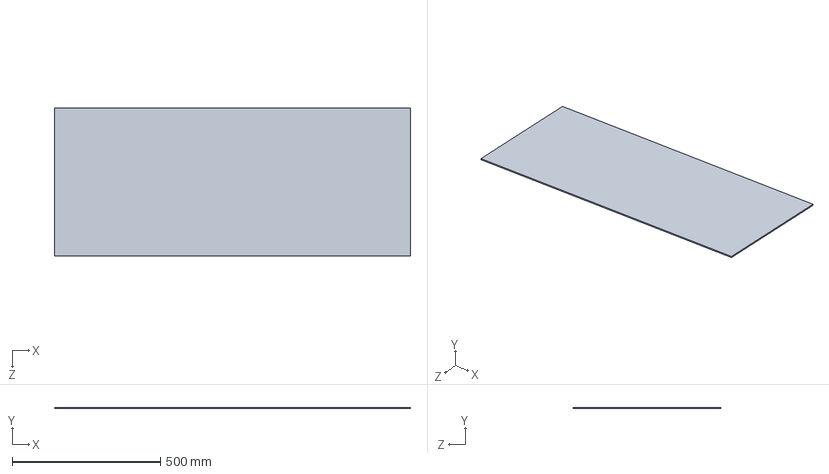
[picture p58: CAD file, 2020-04-03]
CAO/support/Plaque.SLDPRT
1200.0 x 5.00 x 500.0 mm
