JeremyL71/GMP-Projet-fusex/CAO/support/Cloison.SLDPRT

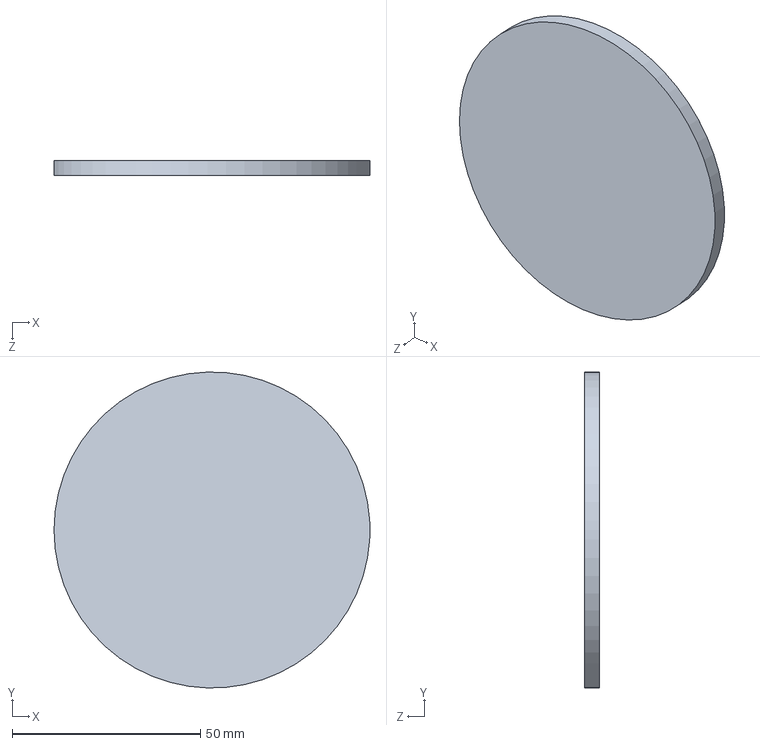
[picture p59: CAD file, 2020-04-03]
CAO/support/Cloison.SLDPRT
84.0 x 84.0 x 4.00 mm
