JeremyL71/GMP-Projet-fusex/CAO/Bluemoon 1bis (last)2/Bague Ailerons.SLDPRT

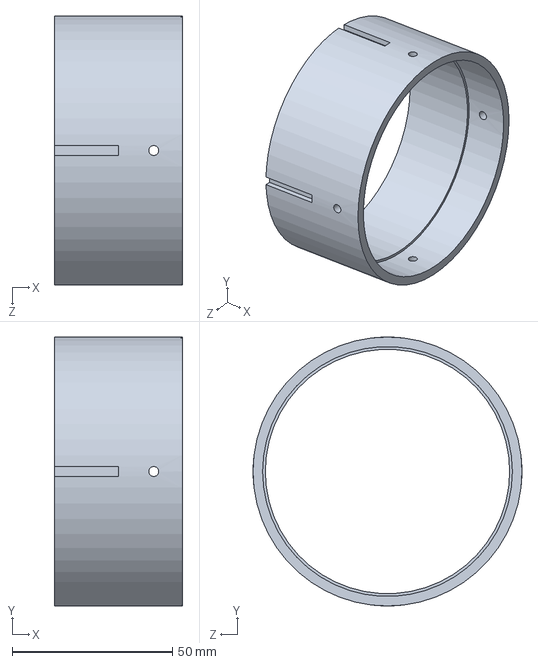
[picture p60: CAD file, 2020-04-03]
CAO/Bluemoon 1bis (last)2/Bague Ailerons.SLDPRT
40.0 x 84.0 x 84.0 mm
