JeremyL71/GMP-Projet-fusex/CAO/Bluemoon 1bis (last)2/tige filet+®.SLDPRT

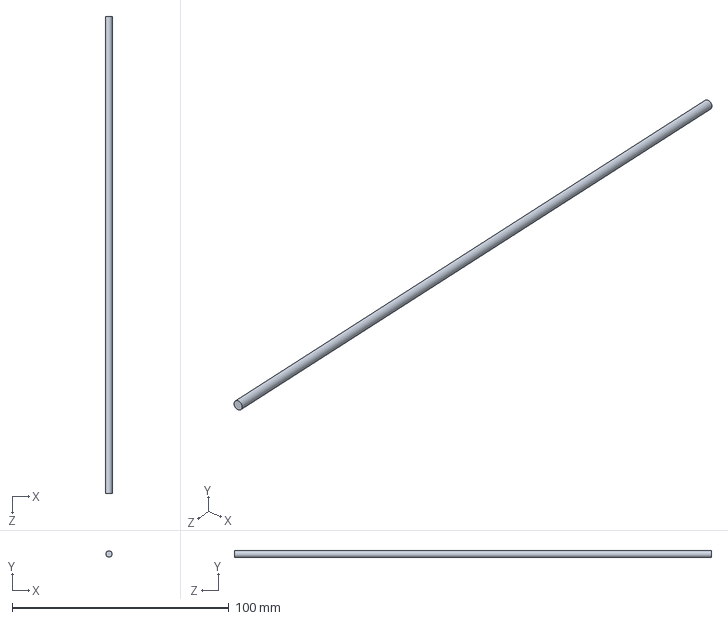
[picture p61: CAD file, 2020-04-03]
CAO/Bluemoon 1bis (last)2/tige filet+®.SLDPRT
3.00 x 3.00 x 220.0 mm
