JeremyL71/GMP-Projet-fusex/CAO/Bluemoon 1bis (last)2/Tube 4.SLDPRT

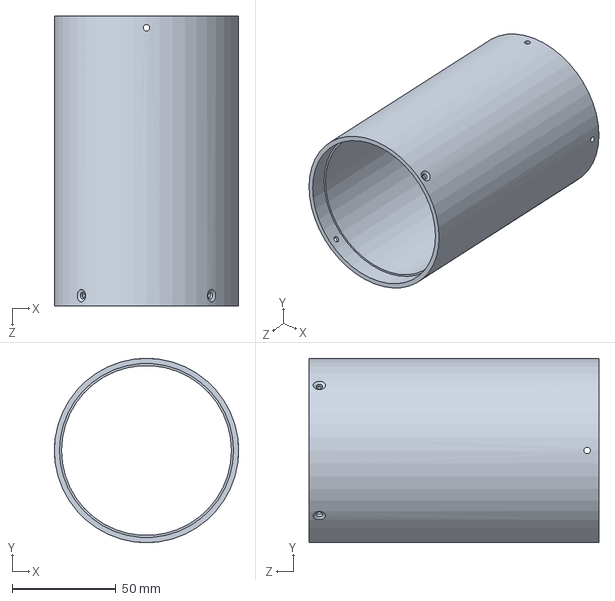
[picture p62: CAD file, 2020-04-03]
CAO/Bluemoon 1bis (last)2/Tube 4.SLDPRT
89.0 x 89.0 x 140.0 mm
