JeremyL71/GMP-Projet-fusex/CAO/Bluemoon 1bis (last)2/din_en_iso_7046-1_m3x12_z.SLDPRT

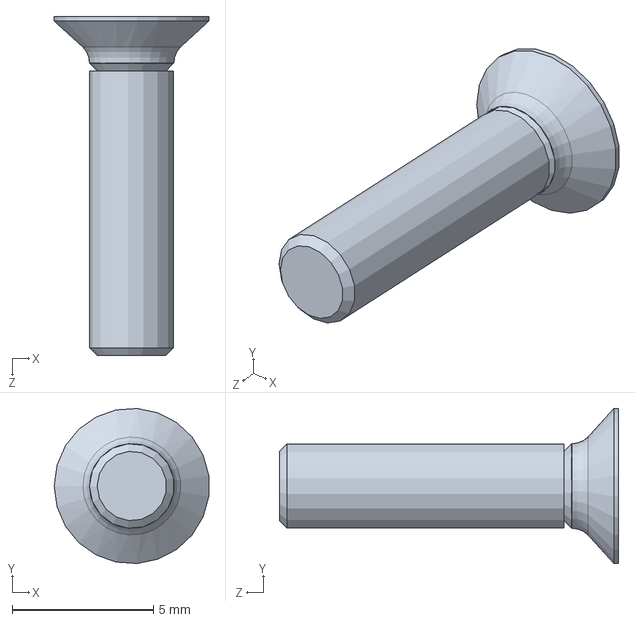
[picture p63: CAD file, 2020-04-03]
CAO/Bluemoon 1bis (last)2/din_en_iso_7046-1_m3x12_z.SLDPRT
5.47 x 5.49 x 12.0 mm
