JeremyL71/GMP-Projet-fusex/CAO/Bluemoon 1bis (last)2/tube haut.SLDPRT

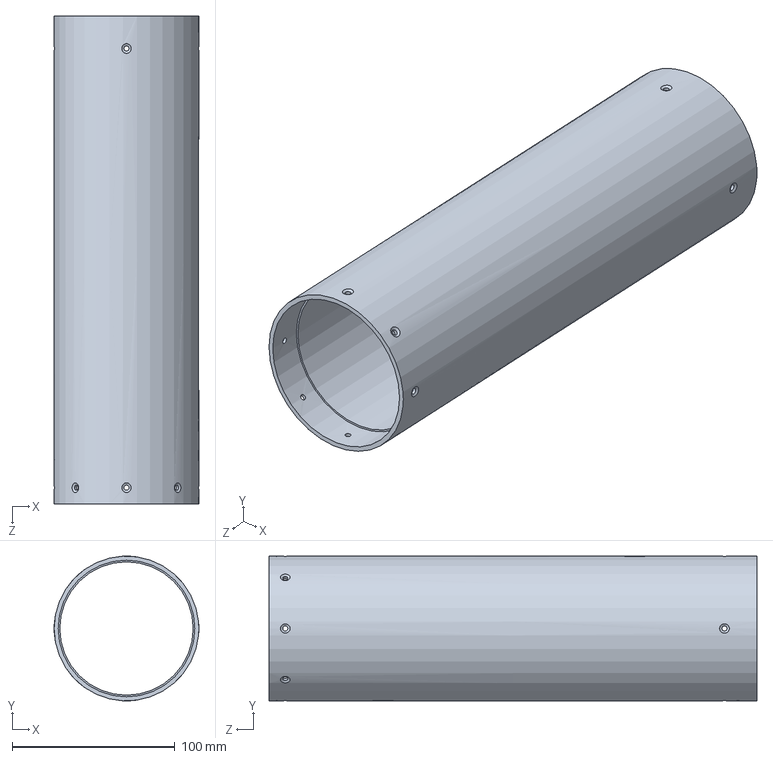
[picture p64: CAD file, 2020-04-03]
CAO/Bluemoon 1bis (last)2/tube haut.SLDPRT
89.0 x 89.0 x 300.0 mm
