JeremyL71/GMP-Projet-fusex/CAO/Bluemoon 1bis (last)2/Appui ressorts.SLDPRT

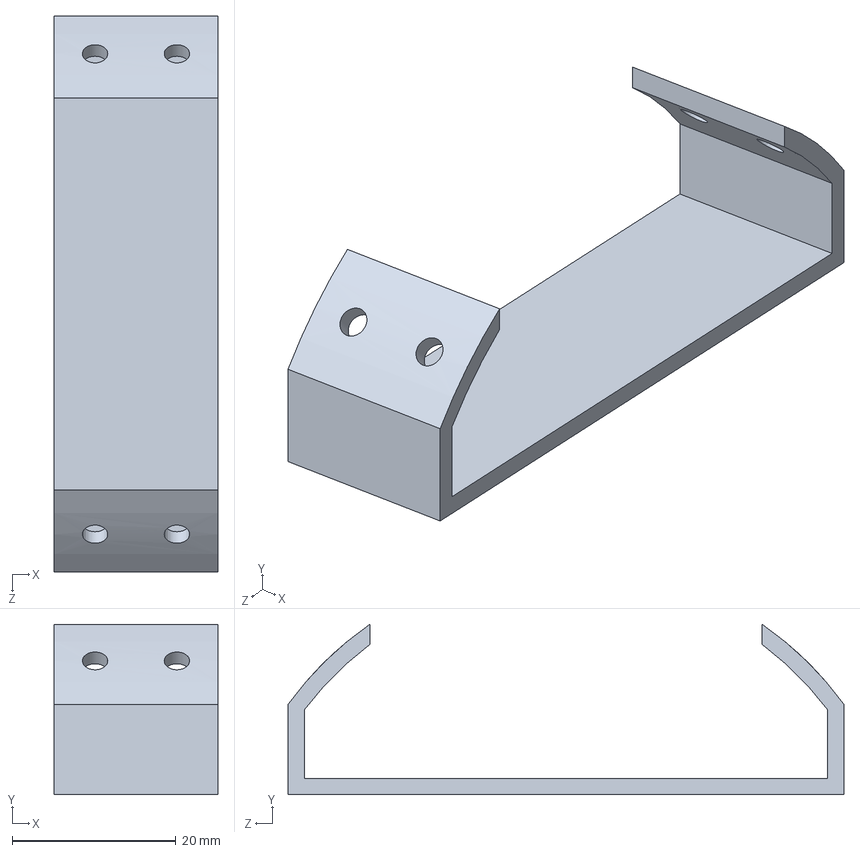
[picture p65: CAD file, 2020-04-03]
CAO/Bluemoon 1bis (last)2/Appui ressorts.SLDPRT
20.0 x 20.8 x 67.9 mm
