JeremyL71/GMP-Projet-fusex/CAO/Bluemoon 1bis (last)2/VIS M3 8-16.SLDPRT

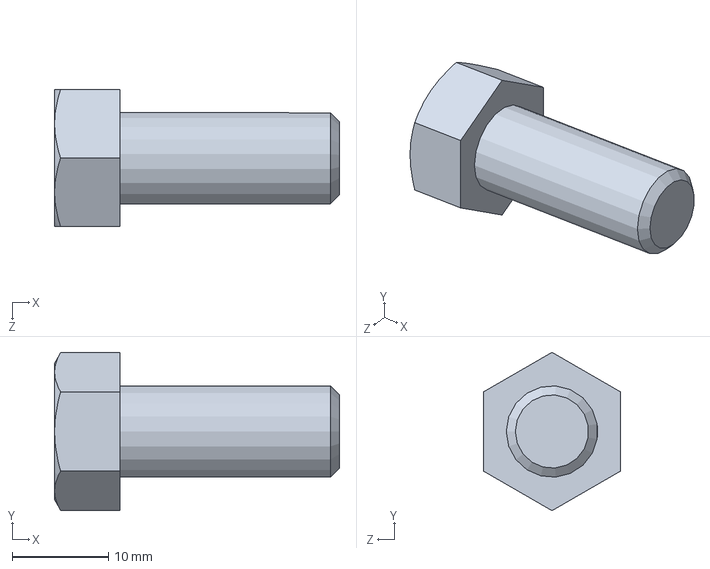
[picture p66: CAD file, 2020-04-03]
CAO/Bluemoon 1bis (last)2/VIS M3 8-16.SLDPRT
29.7 x 16.5 x 14.3 mm
