JeremyL71/GMP-Projet-fusex/CAO/Bluemoon 1bis (last)2/Bride servo.SLDPRT

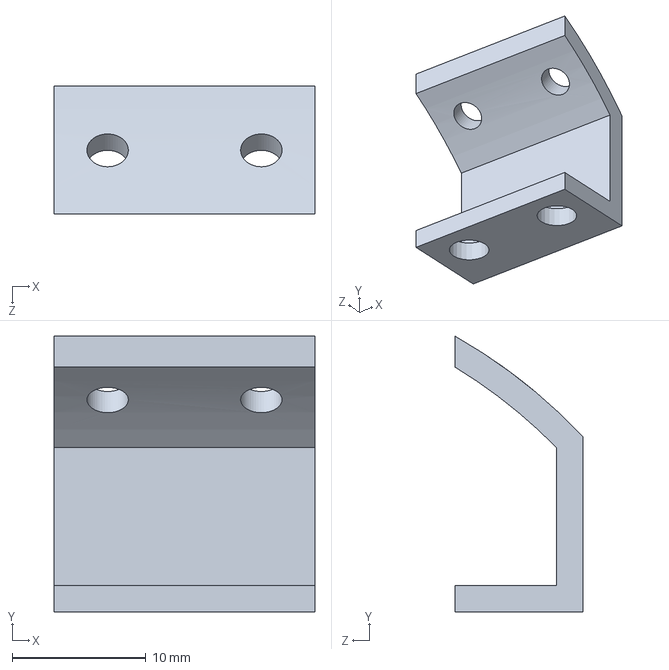
[picture p67: CAD file, 2020-04-03]
CAO/Bluemoon 1bis (last)2/Bride servo.SLDPRT
19.5 x 20.7 x 9.60 mm
