JeremyL71/GMP-Projet-fusex/CAO/Bluemoon 1bis (last)2/Porte capteur.SLDPRT

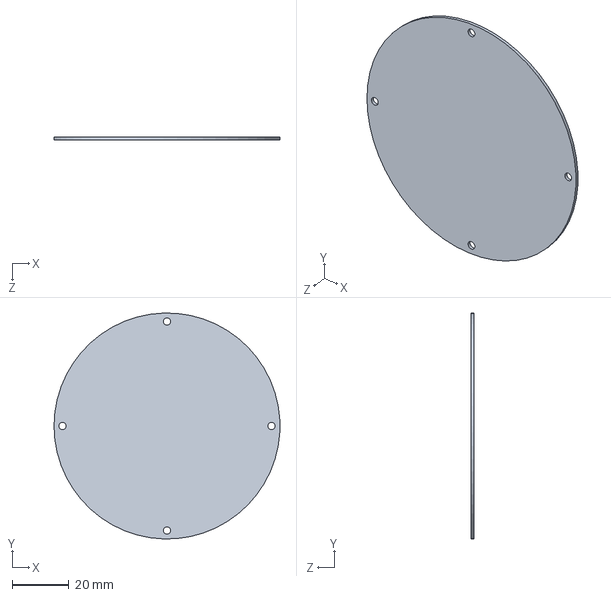
[picture p68: CAD file, 2020-04-03]
CAO/Bluemoon 1bis (last)2/Porte capteur.SLDPRT
80.0 x 80.0 x 1.00 mm
