JeremyL71/GMP-Projet-fusex/(list of files, cad)

Other CAD files:
CAO/servomoteur/servo2/Servo 360°.SLDASM
CAO/servomoteur/servo1/servo.SLDASM
CAO/servomoteur/servo1/spline output.SLDPRT
CAO/Ogive/ogive 2 (1).SLDPRT
CAO/servomoteur/servo2/Vis 2.2 x 18.SLDPRT
CAO/servomoteur/servo1/servo Case.SLDPRT
CAO/servomoteur/servo2/Roue servo360.SLDPRT
CAO/servomoteur/servo1/servo cover.SLDPRT
CAO/servomoteur/servo1/bottom cover.SLDPRT
CAO/support/Moteur 1bis.SLDPRT
CAO/Bluemoon 1bis (last)2/Vis 2.2 x 18.SLDPRT
CAO/support/Aileron.SLDPRT
CAO/Bluemoon 1bis (last)2/Roue servo360.SLDPRT
CAO/Bluemoon 1bis (last)2/ISO 10642 - M3 x 8 - 8S.sldprt
CAO/Bluemoon 1bis (last)2/ISO 4762 M4 x 6 - 6N.sldprt
CAO/Bluemoon 1bis (last)2/ISO 4762 M4 x 6 - 6Nsz.sldprt
CAO/Bluemoon 1bis (last)2/Servo 360.SLDPRT
CAO/Ogive/mise en plan.SLDDRW
CAO/Ogive/ogive 3 moule.SLDDRW
CAO/servomoteur/servo1/long screw.SLDPRT
CAO/servomoteur/servo2/Servo 360.SLDPRT
