JeremyL71/GMP-Projet-fusex/CAO/Ogive/MISE EN plan Ogive.PDF

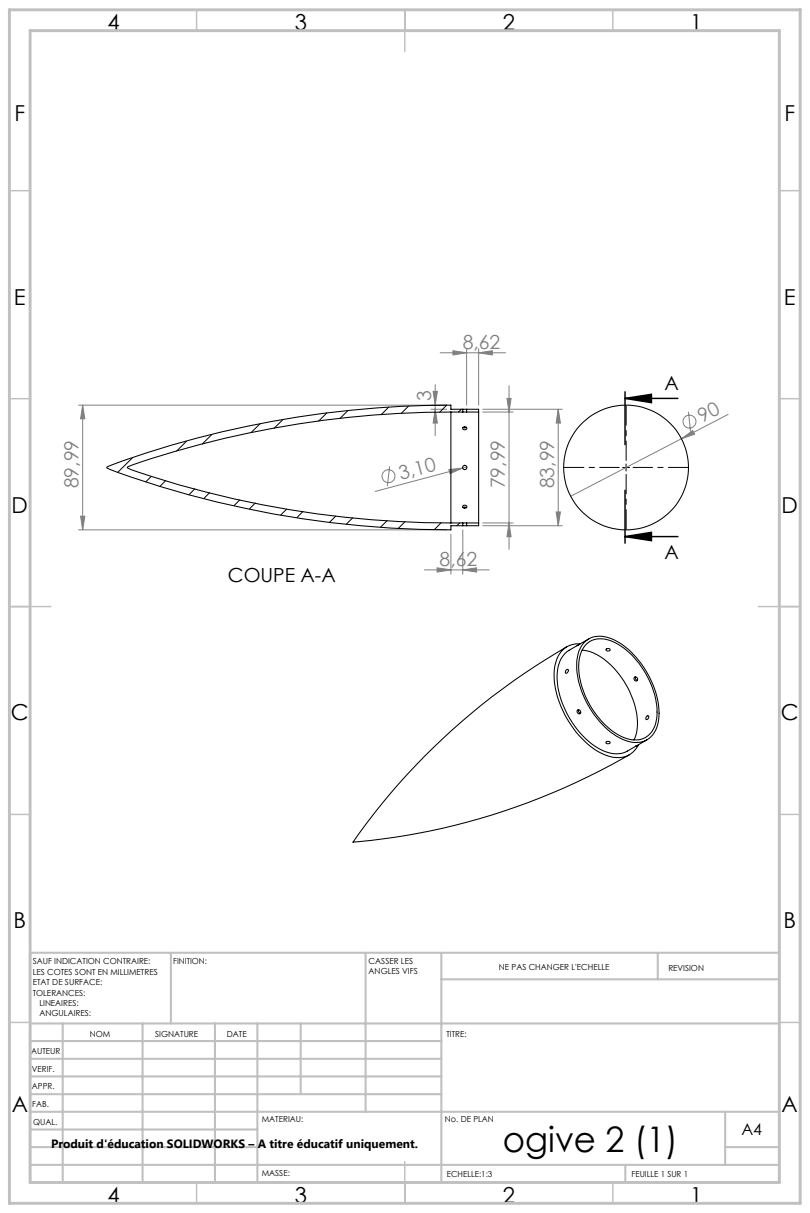
[picture p69: page 1]
COUPE A-A; FINITION:; CASSER LES; ANGLES VIFS; NE PAS CHANGER L'ECHELLE; REVISION

SAUF INDICATION CONTRAIRE:
LES COTES SONT EN MILLIMETRES
ETAT DE SURFACE:
TOLERANCES:
LINEAIRES:
ANGULAIRES:

NOM | SIGNATURE | DATE | | | | TITRE:

AUTEUR
VERIF.
APPR.
FAB.
QUAL. | | | | MATERIAU: | No. DE PLAN ogive 2 (1) | A4
Produit d'éducation SOLIDWORKS – A titre éducatif uniquement.

MASSE: | | ECHELLE:1:3 | FEUILLE 1 SUR 1
